Screase3D/Hexapod-MK3/docs/hexapod_schaltplan_v4.png

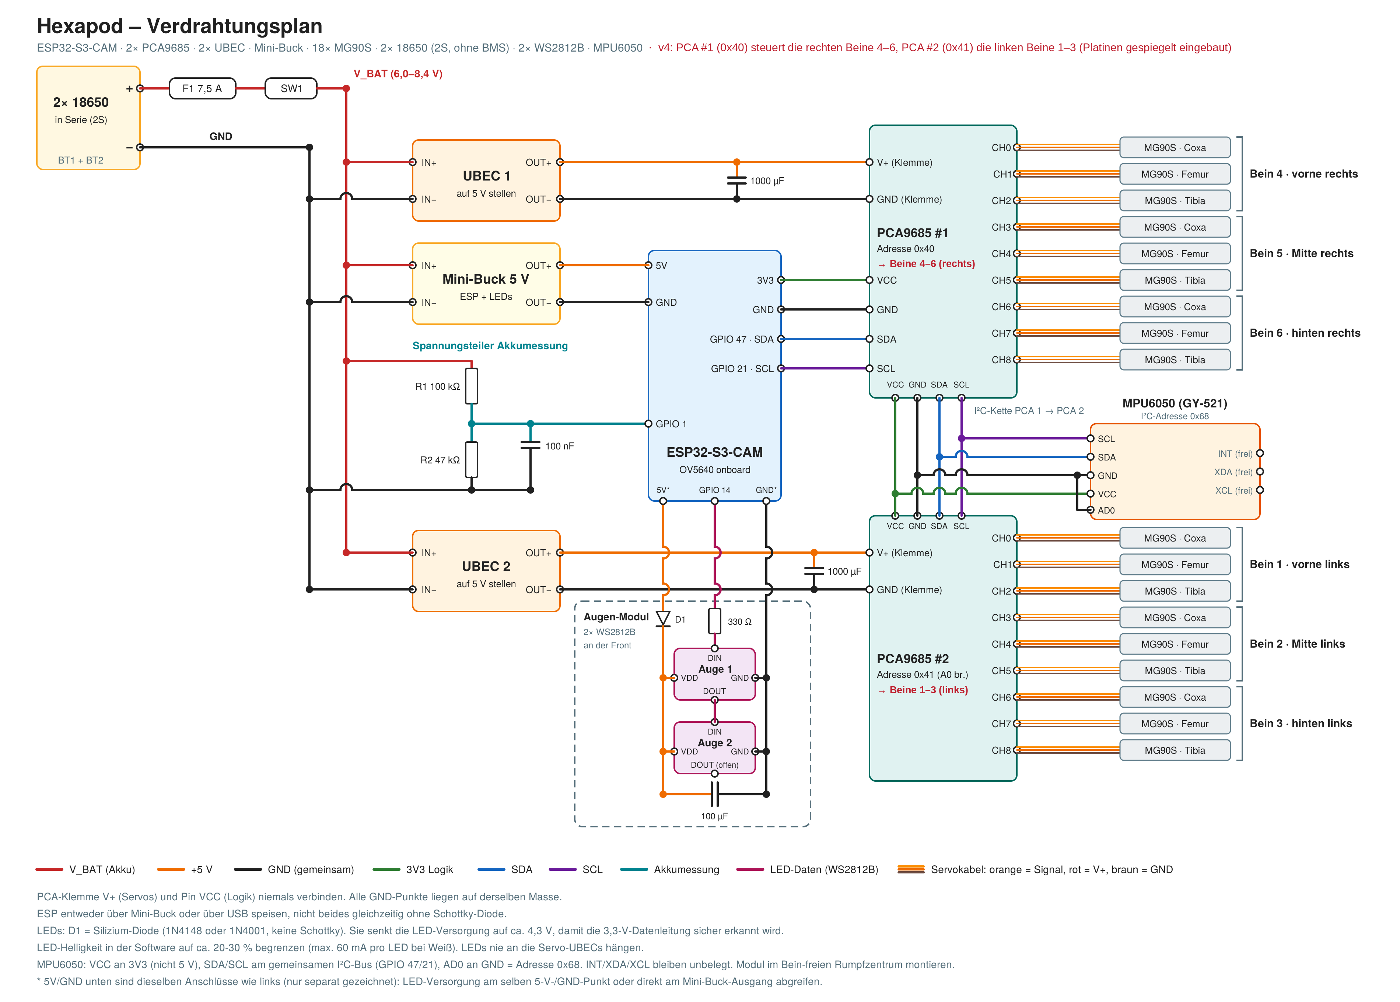
docs/hexapod_schaltplan_v4.png
