Screase3D/Hexapod-MK3/docs/images/ui-phone.png

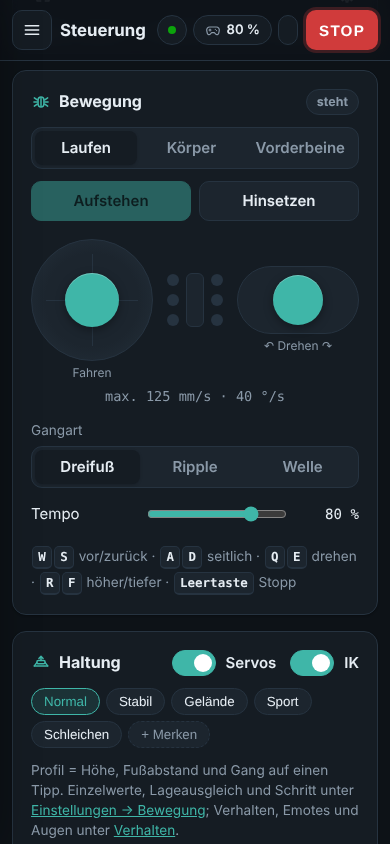
docs/images/ui-phone.png
