Screase3D/Hexapod-MK3/STL/Right Femur.stl

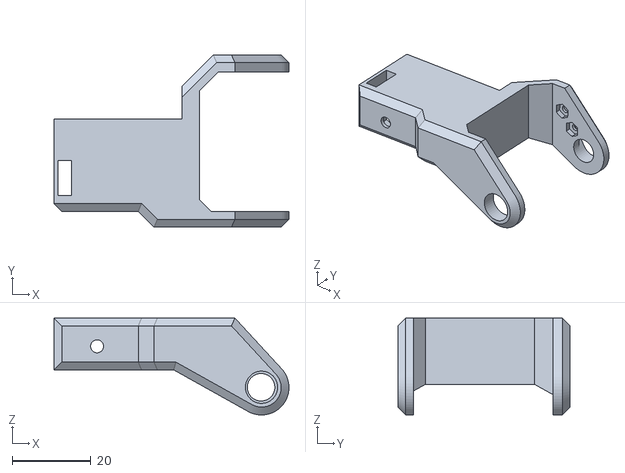
[picture p14: CAD file, 2026-10-17]
STL/Right Femur.stl
59.7 x 43.8 x 24.6
