Screase3D/Hexapod-MK3/STL/Left Tibia Bottom.stl

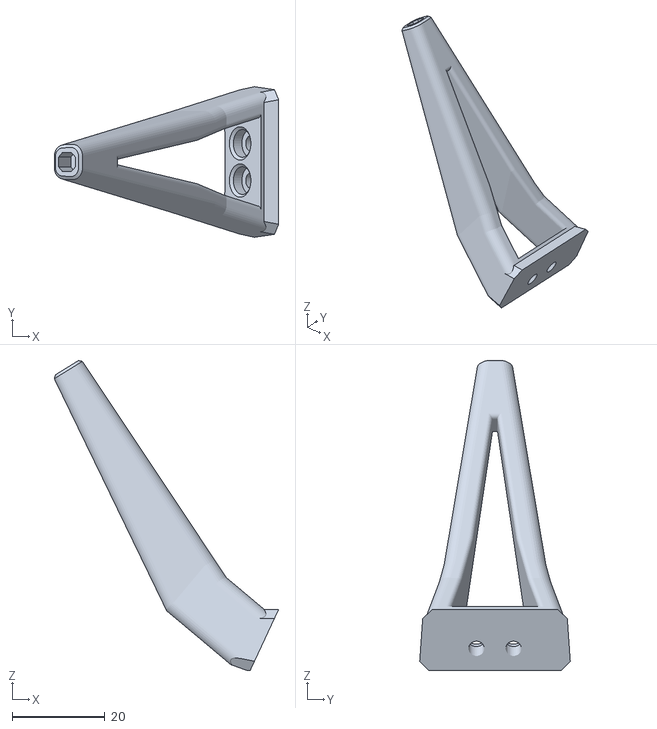
[picture p15: CAD file, 2026-10-17]
STL/Left Tibia Bottom.stl
48.4 x 32.5 x 66.8
