Screase3D/Hexapod-MK3/STL/DeckPlate.stl

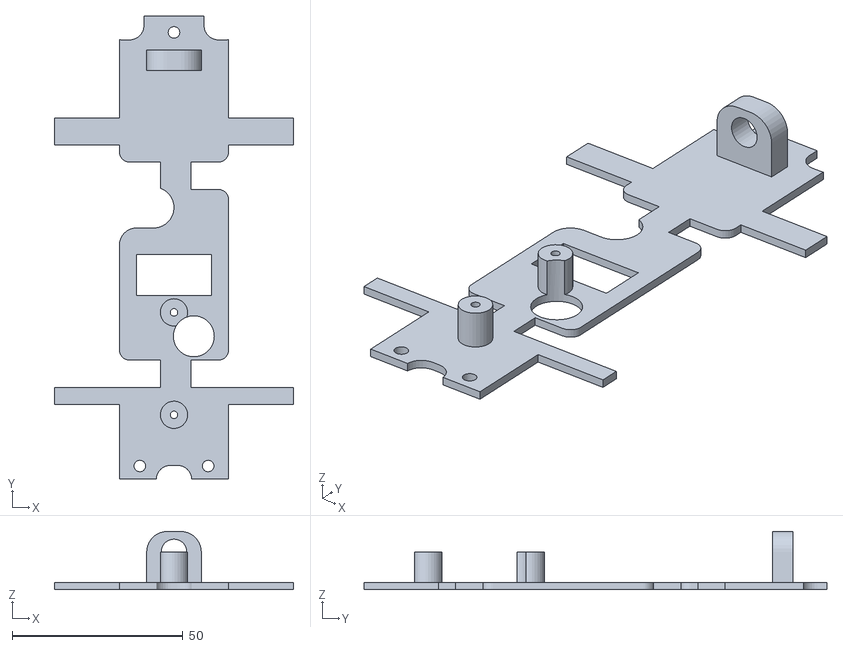
[picture p16: CAD file, 2026-10-17]
STL/DeckPlate.stl
70.0 x 135.6 x 17.0
