Screase3D/Hexapod-MK3/STL/Right Eye.stl

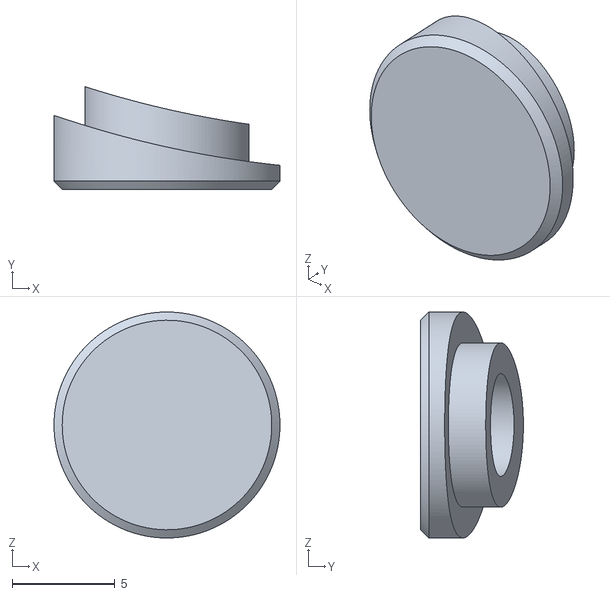
[picture p17: CAD file, 2026-10-17]
STL/Right Eye.stl
11.0 x 5.00 x 11.0
