Screase3D/Hexapod-MK3/STL/Left Coxa outer.stl

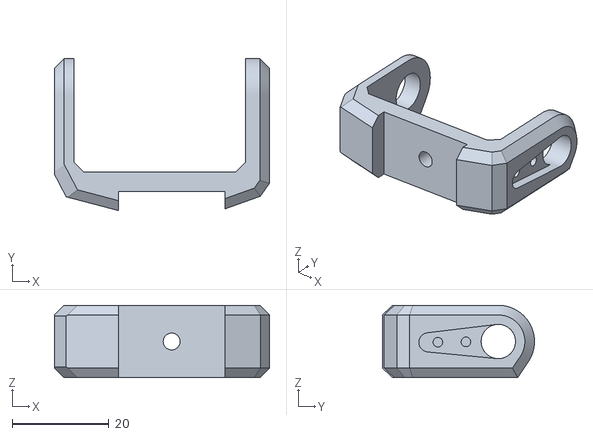
[picture p18: CAD file, 2026-10-17]
STL/Left Coxa outer.stl
44.5 x 31.5 x 15.0
