Screase3D/Hexapod-MK3/STL/TopPlate.stl

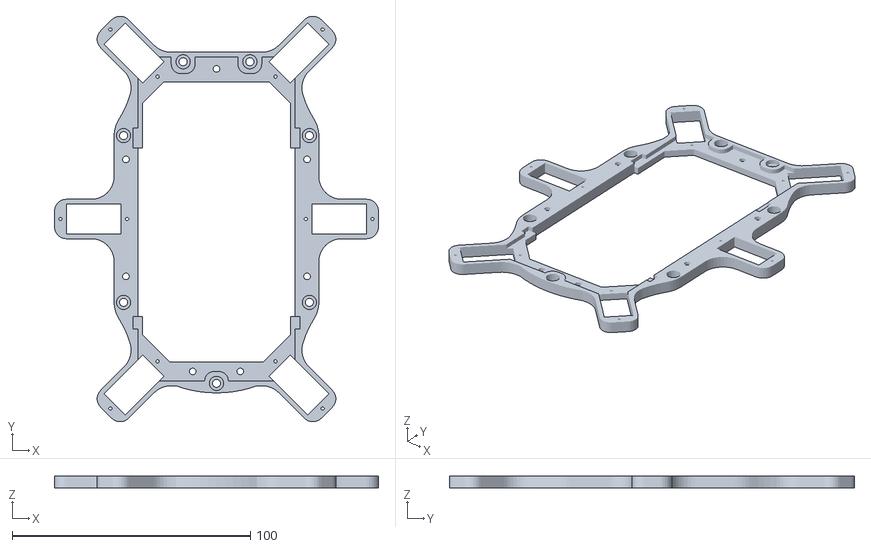
[picture p19: CAD file, 2026-10-17]
STL/TopPlate.stl
136.0 x 170.2 x 5.00
