Screase3D/Hexapod-MK3/STL/Heatsink_Dummy_9x9x4.6mm.stl

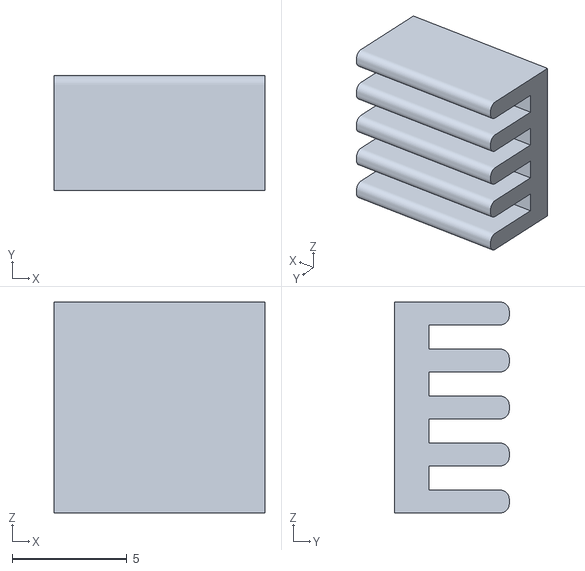
[picture p20: CAD file, 2026-10-17]
STL/Heatsink_Dummy_9x9x4.6mm.stl
9.20 x 5.00 x 9.20
