Screase3D/Hexapod-MK3/STL/Right Tibia Tip_TPU.stl

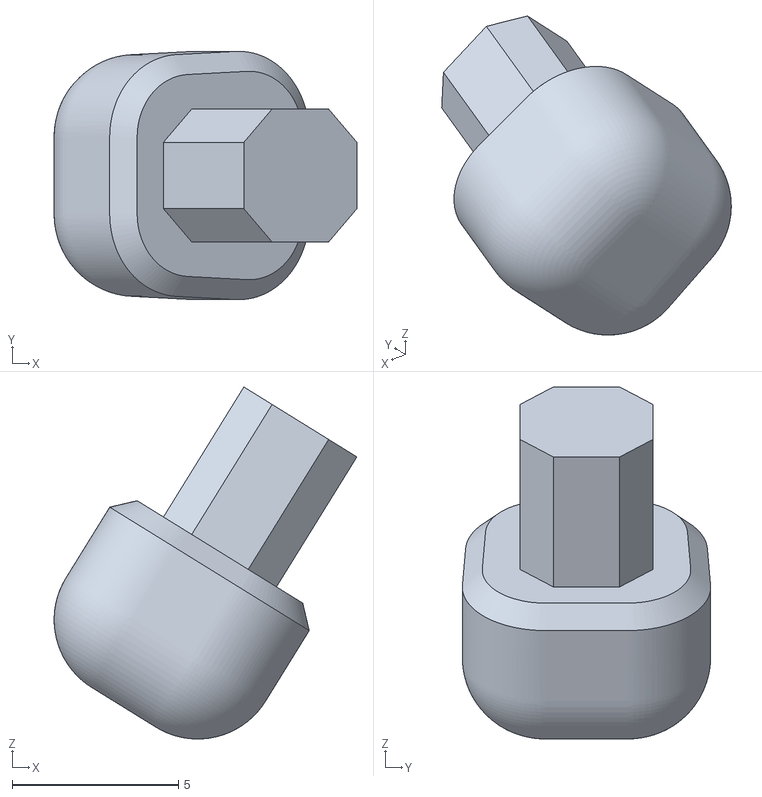
[picture p21: CAD file, 2026-10-17]
STL/Right Tibia Tip_TPU.stl
9.11 x 7.47 x 10.6
