Screase3D/Hexapod-MK3/STL/BatteryFlap.stl

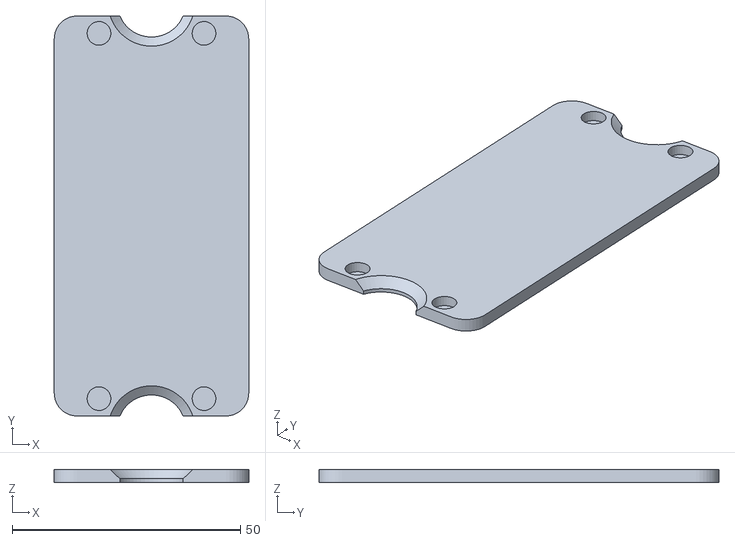
[picture p22: CAD file, 2026-10-17]
STL/BatteryFlap.stl
42.6 x 87.6 x 2.80
