Screase3D/Hexapod-MK3/STL/Left Tibia Top.stl

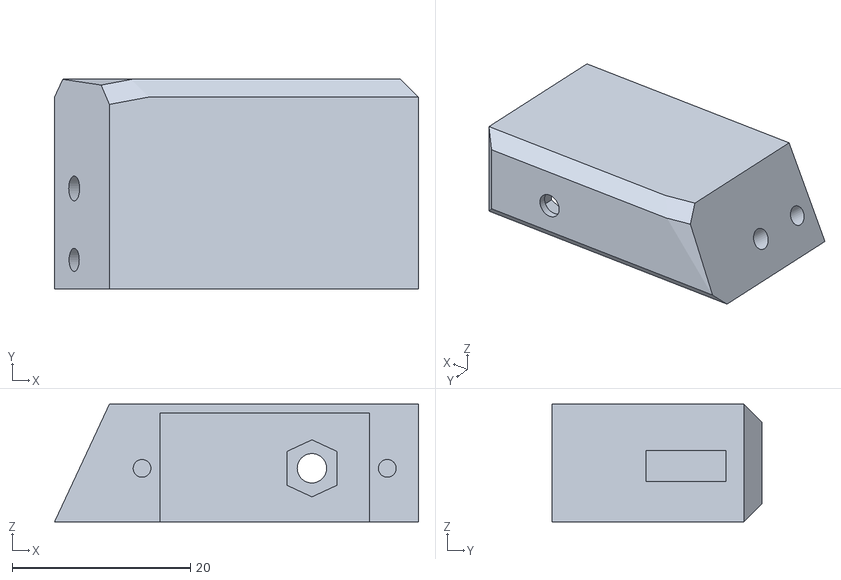
[picture p23: CAD file, 2026-10-17]
STL/Left Tibia Top.stl
40.8 x 23.5 x 13.2
