Screase3D/Hexapod-MK3/STL/Right Coxa inner.stl

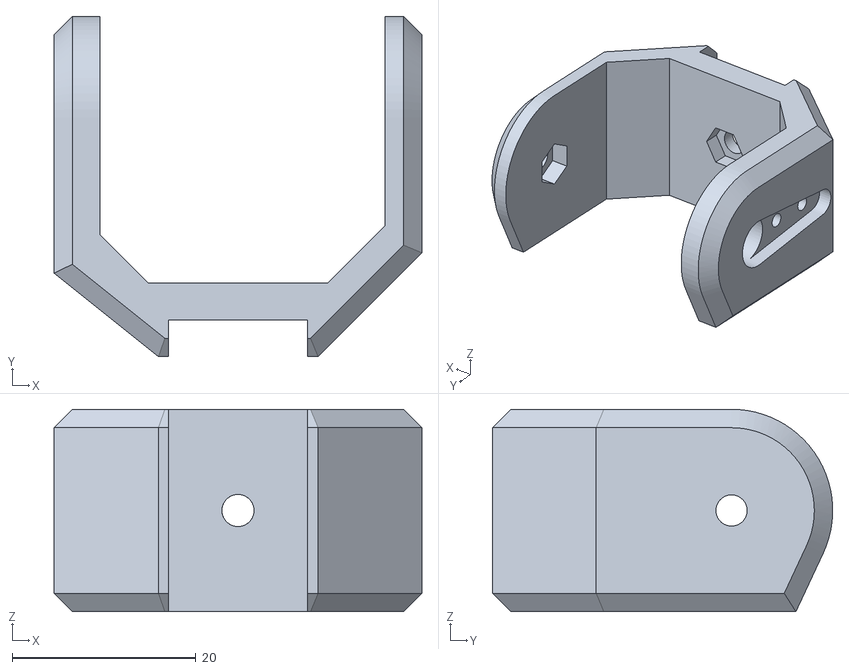
[picture p24: CAD file, 2026-10-17]
STL/Right Coxa inner.stl
40.0 x 37.0 x 22.0
