Screase3D/Hexapod-MK3/STL/Shell_openview.stl

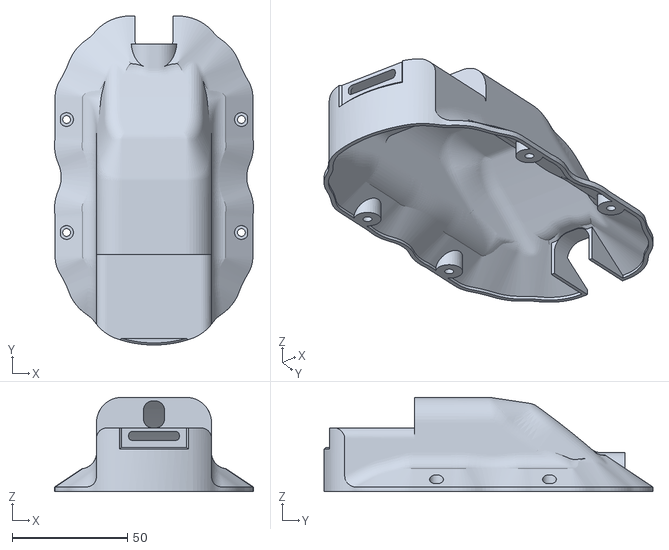
[picture p25: CAD file, 2026-10-17]
STL/Shell_openview.stl
86.5 x 143.0 x 41.0
