Screase3D/Hexapod-MK3/STL/BasePlate.stl

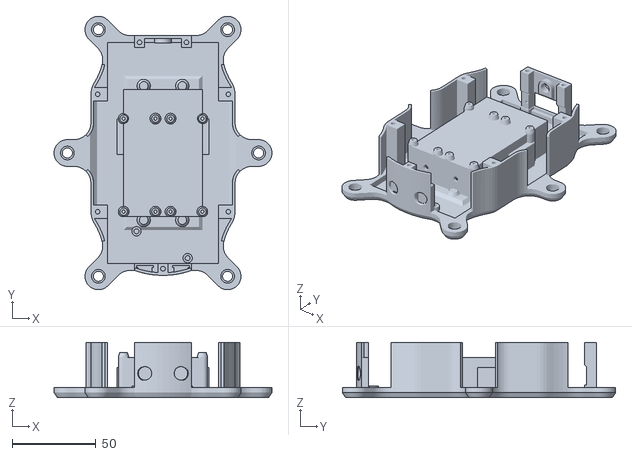
[picture p26: CAD file, 2026-10-17]
STL/BasePlate.stl
130.0 x 163.0 x 33.0
