Screase3D/Hexapod-MK3/STL/ESP_Cam Holder.stl

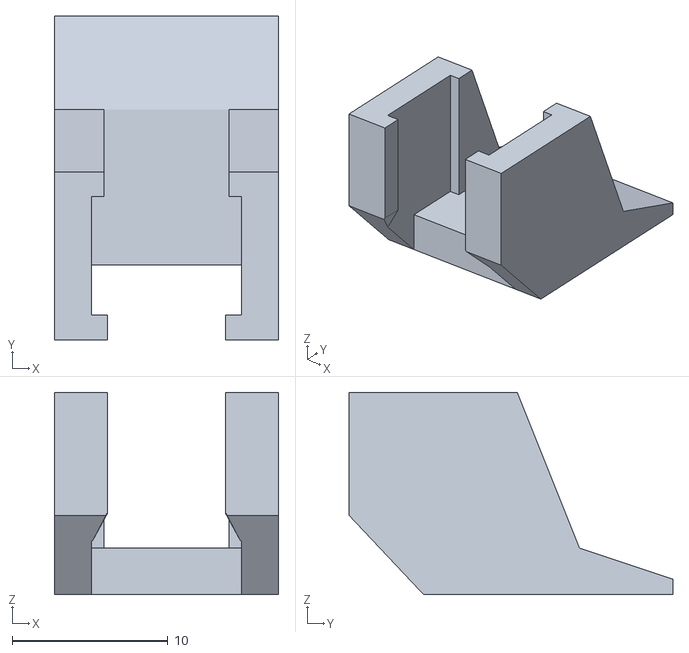
[picture p27: CAD file, 2026-10-17]
STL/ESP_Cam Holder.stl
14.4 x 20.8 x 13.0
