Screase3D/Hexapod-MK3/(list of files, cad)

Other CAD files:
STL/Right Tibia Bottom.stl
STL/Left Eye.stl
STL/Left Femur.stl
STL/Left Tibia Tip_TPU.stl
STL/Right Tibia Top.stl
STL/Right Coxa outer.stl
STL/Left Coxa inner.stl
