Screase3D/Hexapod-MK3/docs/montagelehre.pdf

# Hexapod MK3 – Montagelehre (1:1)

Montagestellung bei 1500 µs: Coxa 0° · Femur +55,4° · Tibia −33,8°. Mit 100 % / „Tatsächliche Größe“ drucken.

Kontrollmaß 50 mm – nachmessen, sonst stimmt der Maßstab nicht

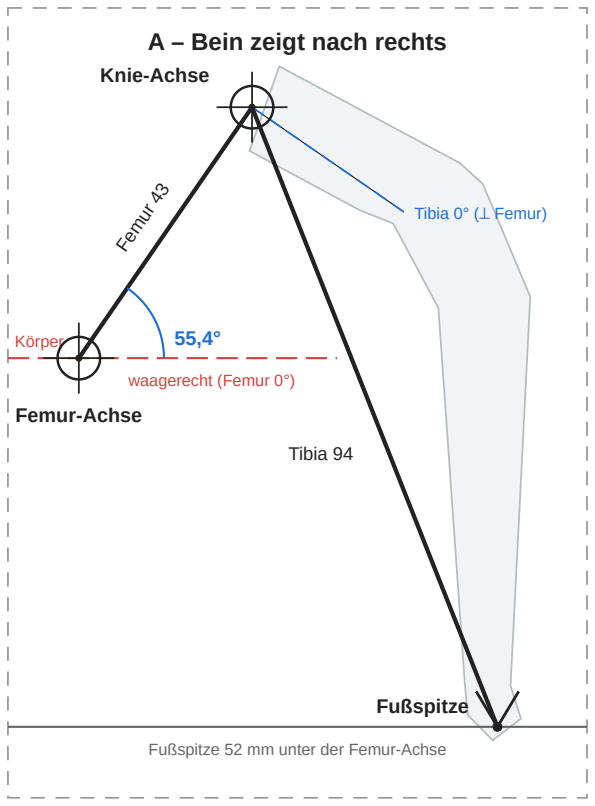
[picture p28: figure]
A – Bein zeigt nach rechts; waagerecht (Femur 0°); Körper; Fußspitze 52 mm unter der Femur-Achse; Femur 43; Tibia 94; Tibia 0° (⟂ Femur); Femur-Achse; Knie-Achse; Fußspitze

### C – Coxa-Winkel (Draufsicht)

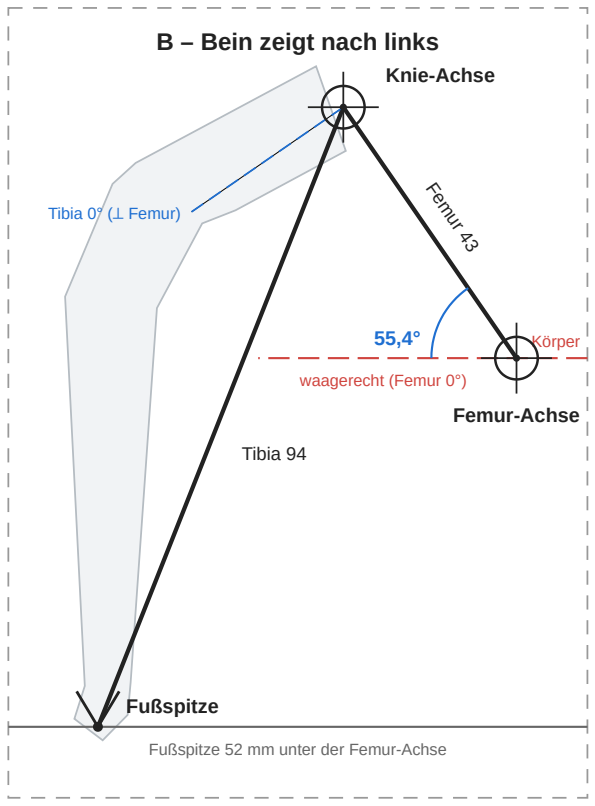
[picture p29: figure]
B – Bein zeigt nach links; waagerecht (Femur 0°); Körper; Fußspitze 52 mm unter der Femur-Achse; Femur 43; Tibia 94; Tibia 0° (⟂ Femur); Femur-Achse; Knie-Achse; Fußspitze
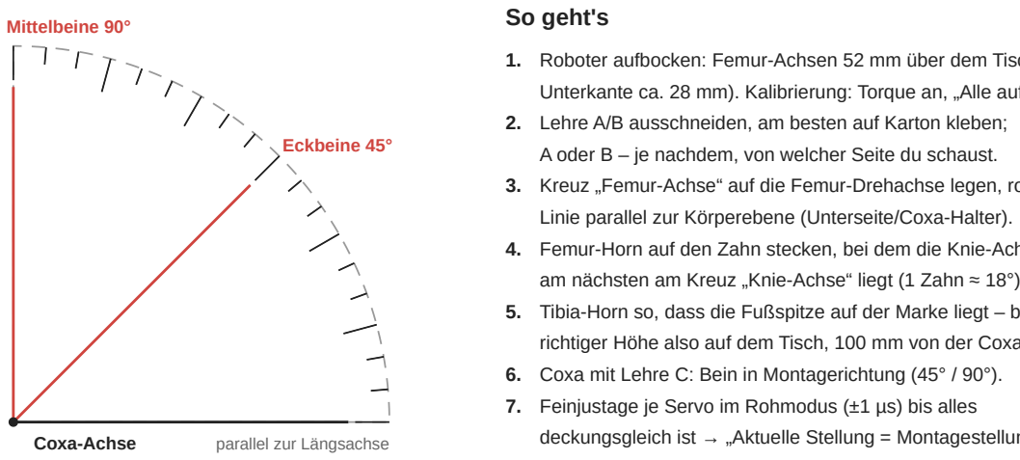
[picture p30: figure]
Coxa-Achse; parallel zur Längsachse; Eckbeine 45°; Mittelbeine 90°; So geht's; Linie parallel zur Körperebene (Unterseite/Coxa-Halter).

### 1. Roboter aufbocken: Femur-Achsen 52 mm über dem Tisch (Chassis-

Unterkante ca. 28 mm). Kalibrierung: Torque an, „Alle auf 1500 µs“.
2. Lehre A/B ausschneiden, am besten auf Karton kleben;
A oder B – je nachdem, von welcher Seite du schaust.

### 3. Kreuz „Femur-Achse“ auf die Femur-Drehachse legen, rote

### 4. Femur-Horn auf den Zahn stecken, bei dem die Knie-Achse

am nächsten am Kreuz „Knie-Achse“ liegt (1 Zahn ≈ 18°).

### 5. Tibia-Horn so, dass die Fußspitze auf der Marke liegt – bei

richtiger Höhe also auf dem Tisch, 100 mm von der Coxa-Achse.
6. Coxa mit Lehre C: Bein in Montagerichtung (45° / 90°).

### 7. Feinjustage je Servo im Rohmodus (±1 µs) bis alles

deckungsgleich ist → „Aktuelle Stellung = Montagestellung“.
Je Bein zuerst Femur, dann Tibia. Details: docs/kalibrierung.md

Linien = Achslinien (Drehpunkt zu Drehpunkt), nicht Bauteilkanten. Erzeugt mit docs/montagelehre.py.
