Screase3D/Hexapod-MK3/firmware/src/motion/motion.cpp

#include "motion.h"

#include <Preferences.h>
#include <atomic>
#include <freertos/FreeRTOS.h>

#include "config.h"
#include "kinematics/alive.h"
#include "kinematics/arms.h"
#include "kinematics/gait.h"
#include "kinematics/gestures.h"
#include "kinematics/kinematics.h"
#include "kinematics/leveling.h"
#include "kinematics/life.h"
#include "kinematics/posture.h"
#include "robot_geometry.h"
#include "sensors/imu.h"
#include "servo/servo_controller.h"
#include "ui/status_leds.h"

namespace motion {
namespace {

constexpr float RAD2DEG = 57.2957795f;
// Einstellungen erst speichern, wenn sich eine Weile nichts mehr geändert hat
// (Schieber erzeugen viele Änderungen, der Flash soll nicht unnötig altern)
constexpr uint32_t SAVE_DELAY_MS = 2000;
constexpr float LEVEL_TILT_MAX = 25.0f;  // Nutzer-Neigung + Lageausgleich zusammen
// Lageausgleich: im Stand schnell (Zeitkonstante 0,25 s), beim Laufen ruhiger – die Schritte
// schaukeln den Körper, darauf soll er nicht jedes Mal reagieren
constexpr float LEVEL_GAIN_STAND = 4.0f, LEVEL_GAIN_WALK = 1.5f;
// Übergang in den IK-Betrieb: Servos höchstens so schnell (Rest zwischen der bisherigen
// Stellung und der IK-Haltung), danach wieder die eingestellte Geschwindigkeit
constexpr float ENTER_SLEW_DEG_PER_S = 90.0f;
// Körper-Joystick: voller Ausschlag verschiebt bzw. neigt den Körper so weit
constexpr float BODY_SHIFT_MM = 30.0f;
constexpr float BODY_TILT_DEG = 12.0f;
constexpr float BODY_YAW_DEG = 15.0f;
constexpr uint32_t LIMITS_REFRESH_MS = 1000;  // Gelenkgrenzen aus der Kalibrierung neu lesen

struct PoseState {
  kin::BodyPose pose;
  float stance;
};

portMUX_TYPE g_mux = portMUX_INITIALIZER_UNLOCKED;
// --- geschützt durch g_mux (Web-Handler <-> Regel-Task) ---
Mode g_mode = Mode::Manual;
PoseState g_target;
bool g_enter_pose = false;      // beim Wechsel in den Pose-Modus Haltung übernehmen
bool g_leave_pose = false;      // Rampen-Untergrenze im Regel-Task zurücksetzen
bool g_req_stand = false;
bool g_req_sit = false;
posture::State g_posture = posture::State::Sitting;  // für die Telemetrie
float g_walk_cmd[3] = {0, 0, 0};
uint32_t g_walk_ms = 0;         // Zeitpunkt des letzten Fahrbefehls
gait::Params g_gait_params;
uint8_t g_unreachable = 0;      // Bitmaske Beine 0..5
uint32_t g_clamped = 0;         // Bitmaske Gelenke 0..17 (an Kalibriergrenze)
bool g_leveling = false;        // Lageausgleich eingeschaltet
bool g_level_fault = false;     // ... wegen falscher Sensorrichtung abgeschaltet
bool g_level_active = false;
float g_level_corr[2] = {0, 0};  // Roll, Nick
uint32_t g_dirty_ms = 0;        // letzte Änderung an gespeicherten Einstellungen (0 = keine)
struct GaitStatus {
  bool walking;
  uint8_t swing;
  float vx, vy, wz_deg, max_speed, max_side, max_turn_deg, nominal, cadence;
  gait::Type type;
  bool switching;  // Gangwechsel im Lauf läuft noch
  float climb_height;  // Fußhub beim Klettern (mm)
} g_status = {};
float g_body_cmd[5] = {0, 0, 0, 0, 0};  // Körper-Joystick: x, y, roll, pitch, yaw (normiert)
uint32_t g_body_ms = 0;
float g_arm_cmd[5] = {0, 0, 0, 0, 0};   // Vorderfüße: lx, lz, rx, rz, reach (normiert)
uint32_t g_arm_ms = 0;
uint8_t g_req_arms = 0;                 // 1 = heben, 2 = absetzen
bool g_req_wave = false;
gestures::Type g_req_gesture = gestures::Type::None;
bool g_req_gesture_stop = false;
arms::State g_arms_state = arms::State::Down;   // für Telemetrie und Befehlsprüfung
gestures::Type g_gesture = gestures::Type::None;
bool g_offset_limited = false;          // Körper-Joystick/Vorderbeine an der Reichweitengrenze
bool g_body_active = false;
bool g_alive = false;                   // "Lebendig" eingeschaltet
alive::Action g_alive_act = alive::Action::None;
life::Config g_life;                    // "Lebendig wirken"
life::Mood g_mood = life::Mood::Awake;  // für die Telemetrie
bool g_flailing = false;

// --- nur im Regel-Task ---
PoseState g_current;
gait::Gait g_gait;
posture::Sequencer g_seq{posture::Config{SIT_HEIGHT, SIT_STANCE, SIT_RISE_S}};
bool g_settling = false;  // Übergang in die IK-Haltung läuft noch (normale Rampe)
leveling::Controller g_level;
arms::Controller g_arms;
gestures::Player g_gest;
alive::Animator g_anim{LEG_MOUNTS};
life::Moods g_moods;
life::Breath g_breath;
life::LiftDetector g_lift;
life::Flail g_flail;
life::WalkFx g_walkfx;
alive::Action g_mood_play = alive::Action::None;  // wartet, bis "Lebendig" frei ist
uint32_t g_look_at = 0;                            // nach dem Anhalten umschauen (millis, 0 = nein)
float g_gaze = 0.0f;
bool g_life_eyes = false;                          // Augen-Vorgaben gesetzt
bool g_pending_sit = false;   // Hinsetzen, sobald die Vorderbeine unten sind
float g_lo[NUM_SERVOS], g_hi[NUM_SERVOS];
uint32_t g_limits_ms = 0;
kin::BodyPose g_ik_pose = {0, 0, POSE_LIMITS.height_default, 0, 0, 0};  // Körperlage der letzten IK
kin::BodyPose g_live_pose = g_ik_pose;  // dieselbe, unter g_mux (Live-Ansicht)
float g_pose_vel[7] = {0, 0, 0, 0, 0, 0, 0};
std::atomic<uint32_t> g_update_seq{0};  // abgeschlossene Regelschritte (update)  // Nachführen der Haltung: x, y, z, Rollen, Nicken, Gieren, Fußabstand

// Vorderbeine: Fußpunkt erreichbar (mit Abstand zu den Gelenkgrenzen)?
constexpr float ARM_MARGIN_DEG = 3.0f;
constexpr int FRONT_LEGS[2] = {0, 3};
bool armReachable(void*, int k, const kin::Vec3& foot) {
  const int leg = FRONT_LEGS[k];
  return kin::footReachable(LEG_GEOMETRY, LEG_MOUNTS[leg], g_ik_pose, foot, &g_lo[leg * 3], &g_hi[leg * 3],
                            ARM_MARGIN_DEG, KNEE_MIN_DEG);
}

PoseState defaults() {
  PoseState s;
  s.pose = {0.0f, 0.0f, POSE_LIMITS.height_default, 0.0f, 0.0f, 0.0f};
  s.stance = POSE_LIMITS.stance_default;
  return s;
}

PoseState sitState() {
  PoseState s;
  s.pose = {0.0f, 0.0f, SIT_HEIGHT, 0.0f, 0.0f, 0.0f};
  s.stance = SIT_STANCE;
  return s;
}

gait::Params defaultGait() {
  gait::Params p;
  p.swing_s = GAIT_LIMITS.swing_default;
  p.step_height = GAIT_LIMITS.height_default;
  p.max_stride = gaitStrideMax(p.step_height);
  return p;
}

// NaN (sollte nie vorkommen) wird zur Mitte des Bereichs statt durchgereicht
float clampf(float v, float lo, float hi) { return v < lo ? lo : (v > hi ? hi : (v == v ? v : 0.5f * (lo + hi))); }

float approach(float cur, float target, float max_step) {
  float d = target - cur;
  if (d > max_step) return cur + max_step;
  if (d < -max_step) return cur - max_step;
  return target;
}

// Folgt dem Ziel mit begrenzter Geschwindigkeit und Beschleunigung: weich anfahren,
// rechtzeitig abbremsen, ohne Überschwingen (vel = Zustand je Achse)
float glide(float cur, float target, float& vel, float vmax, float amax, float dt) {
  if (dt <= 0.0f) return cur;
  const float d = target - cur;
  // Bremsgeschwindigkeit im Regeltakt: kommt mit amax genau am Ziel zum Stehen
  const float ad = amax * dt;
  const float v_stop = ad * (sqrtf(0.25f + 2.0f * fabsf(d) / (ad * dt)) - 0.5f);
  const float v_want = copysignf(fminf(vmax, fminf(v_stop, fabsf(d) / dt)), d);
  vel = approach(vel, v_want, ad);
  const float next = cur + vel * dt;
  if ((target - next) * d <= 0.0f) {  // angekommen
    vel = 0.0f;
    return target;
  }
  return next;
}

void neutralFeet(float stance, kin::Vec3 out[NUM_LEGS]) {
  for (int leg = 0; leg < NUM_LEGS; ++leg) out[leg] = kin::stanceFoot(LEG_MOUNTS[leg], stance);
}

// Gelenkwinkel aller Beine für die Körperlage und Fußpunkte (Lauf-System);
// unerreichbare Beine behalten ihre bisherigen Werte (Bitmaske zurück)
uint8_t solveIk(const kin::BodyPose& pose, const kin::Vec3 feet[NUM_LEGS], float angles[NUM_SERVOS]) {
  uint8_t unreachable = 0;
  for (int leg = 0; leg < NUM_LEGS; ++leg) {
    const kin::LegMount& mount = LEG_MOUNTS[leg];
    kin::Vec3 foot_leg = kin::bodyToLeg(mount, kin::worldToBody(pose, feet[leg]));
    kin::JointAngles a;
    if (kin::legIk(LEG_GEOMETRY, mount, foot_leg, a)) {
      angles[leg * 3 + 0] = a.coxa;
      angles[leg * 3 + 1] = a.femur;
      angles[leg * 3 + 2] = a.tibia;
    } else {
      unreachable |= 1 << leg;
    }
  }
  return unreachable;
}

float g_angles[NUM_SERVOS] = {};

// ---- Haltungsprüfung: Füße auf den Neutralpunkten erreichbar und in den Gelenkgrenzen?
void readLimits(float lo[NUM_SERVOS], float hi[NUM_SERVOS]) {
  for (int i = 0; i < NUM_SERVOS; ++i) {
    ServoCal c = servos.getCal(i);
    lo[i] = c.min_deg;
    hi[i] = c.max_deg;
  }
}

kin::PoseCheck checkState(const PoseState& s, float mid_dx, const float* lo, const float* hi) {
  kin::Vec3 feet[NUM_LEGS];
  neutralFeet(s.stance, feet);
  feet[1].x += mid_dx;  // Mittelbeine (Vorderbeine-Modus)
  feet[4].x += mid_dx;
  return kin::checkPose(LEG_GEOMETRY, LEG_MOUNTS, NUM_LEGS, s.pose, feet, lo, hi);
}

PoseState lerpState(const PoseState& a, const PoseState& b, float t) {
  PoseState r;
  r.pose.x = a.pose.x + (b.pose.x - a.pose.x) * t;
  r.pose.y = a.pose.y + (b.pose.y - a.pose.y) * t;
  r.pose.z = a.pose.z + (b.pose.z - a.pose.z) * t;
  r.pose.roll_deg = a.pose.roll_deg + (b.pose.roll_deg - a.pose.roll_deg) * t;
  r.pose.pitch_deg = a.pose.pitch_deg + (b.pose.pitch_deg - a.pose.pitch_deg) * t;
  r.pose.yaw_deg = a.pose.yaw_deg + (b.pose.yaw_deg - a.pose.yaw_deg) * t;
  r.stance = a.stance + (b.stance - a.stance) * t;
  return r;
}

// "Lebendig"-Versatz mit Anteil k zu Körperlage und Füßen addieren
void addAlive(kin::BodyPose& p, kin::Vec3 feet[NUM_LEGS], const alive::Output& al, float k) {
  p.x += al.body.x * k;
  p.y += al.body.y * k;
  p.z += al.body.z * k;
  p.roll_deg += al.body.roll * k;
  p.pitch_deg += al.body.pitch * k;
  p.yaw_deg += al.body.yaw * k;
  for (int leg = 0; leg < NUM_LEGS; ++leg) {
    feet[leg].x += al.foot[leg].x * k;
    feet[leg].y += al.foot[leg].y * k;
    feet[leg].z += al.foot[leg].z * k;
  }
}

// ... und zwar so viel davon, wie erreichbar ist (Haltung nahe an den Grenzen)
void applyAlive(kin::BodyPose& pose, kin::Vec3 feet[NUM_LEGS], const alive::Output& al) {
  auto ok = [&](float k) {
    kin::BodyPose p = pose;
    kin::Vec3 f[NUM_LEGS];
    for (int leg = 0; leg < NUM_LEGS; ++leg) f[leg] = feet[leg];
    addAlive(p, f, al, k);
    return kin::checkPose(LEG_GEOMETRY, LEG_MOUNTS, NUM_LEGS, p, f, g_lo, g_hi).ok();
  };
  float k = 1.0f;
  if (!ok(1.0f)) {
    float k_bad = 1.0f;
    k = 0.0f;
    for (int i = 0; i < 8; ++i) {
      float mid = 0.5f * (k + k_bad);
      if (ok(mid)) k = mid;
      else k_bad = mid;
    }
  }
  addAlive(pose, feet, al, k);
}

// Größter Anteil t (0..1) des Wegs von a (zulässig) nach b, der zulässig bleibt
float feasibleFraction(const PoseState& a, const PoseState& b, float mid_dx, const float* lo, const float* hi) {
  if (checkState(b, mid_dx, lo, hi).ok()) return 1.0f;
  float t_ok = 0.0f, t_bad = 1.0f;
  for (int i = 0; i < 10; ++i) {
    float mid = 0.5f * (t_ok + t_bad);
    if (checkState(lerpState(a, b, mid), mid_dx, lo, hi).ok()) t_ok = mid;
    else t_bad = mid;
  }
  return t_ok;
}

// "Bein 2" bzw. "Beine 1, 4"
String legsText(uint8_t mask) {
  String s;
  for (int leg = 0; leg < NUM_LEGS; ++leg) {
    if (!(mask & (1 << leg))) continue;
    if (!s.isEmpty()) s += ", ";
    s += String(leg + 1);
  }
  return (__builtin_popcount(mask) > 1 ? "Beine " : "Bein ") + s;
}

struct PoseField {
  const char* key;
  const char* label;
  const char* unit;
};
constexpr PoseField POSE_FIELDS[] = {
    {"z", "Höhe", "mm"},         {"stance", "Fußabstand", "mm"}, {"x", "Vor/zurück", "mm"},
    {"y", "Links/rechts", "mm"}, {"roll", "Rollen", "°"},        {"pitch", "Nicken", "°"},
    {"yaw", "Gieren", "°"},
};

float fieldValue(const PoseState& s, int i) {
  switch (i) {
    case 0:  return s.pose.z;
    case 1:  return s.stance;
    case 2:  return s.pose.x;
    case 3:  return s.pose.y;
    case 4:  return s.pose.roll_deg;
    case 5:  return s.pose.pitch_deg;
    default: return s.pose.yaw_deg;
  }
}

void setFieldValue(PoseState& s, int i, float v) {
  switch (i) {
    case 0:  s.pose.z = v; break;
    case 1:  s.stance = v; break;
    case 2:  s.pose.x = v; break;
    case 3:  s.pose.y = v; break;
    case 4:  s.pose.roll_deg = v; break;
    case 5:  s.pose.pitch_deg = v; break;
    default: s.pose.yaw_deg = v; break;
  }
}

void fieldLimits(int i, float& lo, float& hi) {
  const PoseLimits& L = POSE_LIMITS;
  switch (i) {
    case 0:  lo = L.height_min, hi = L.height_max; break;
    case 1:  lo = L.stance_min, hi = L.stance_max; break;
    case 2:
    case 3:  lo = -L.shift_max, hi = L.shift_max; break;
    case 4:
    case 5:  lo = -L.tilt_max, hi = L.tilt_max; break;
    default: lo = -L.yaw_max, hi = L.yaw_max; break;
  }
}

// Zulässiger Bereich jeder Haltungsgröße bei den übrigen Zielwerten – für die Regler der
// Oberfläche. Einige hundert Haltungsprüfungen (wenige ms) -> nur bei geändertem Ziel und
// alle 2 s (Kalibrierung geändert). Nur aus dem Telemetrie-Aufbau (Hauptschleife).
struct RangeCtx {
  PoseState s;
  int field;
  const float* lo;
  const float* hi;
};
bool fieldOk(void* ctx, float v) {
  const RangeCtx* c = static_cast<const RangeCtx*>(ctx);
  PoseState s = c->s;
  setFieldValue(s, c->field, v);
  return checkState(s, 0.0f, c->lo, c->hi).ok();
}
constexpr uint32_t RANGE_REFRESH_MS = 2000;

// Was eine Haltung verhindert (für die Anzeige am Regler): Bein, Gelenk (0 Coxa, 1 Femur,
// 2 Tibia, 3 = Fuß nicht erreichbar) und die Kalibriergrenze, die am weitesten überschritten wäre
struct LimitWhy {
  int8_t leg = -1;  // < 0: keine Angabe
  int8_t joint = 0;
  float limit = 0.0f;
};
LimitWhy limitWhy(const PoseState& s, const float* lo, const float* hi) {
  kin::Vec3 feet[NUM_LEGS];
  neutralFeet(s.stance, feet);
  LimitWhy w;
  float worst = 0.0f;
  for (int leg = 0; leg < NUM_LEGS; ++leg) {
    kin::JointAngles a;
    if (!kin::legIk(LEG_GEOMETRY, LEG_MOUNTS[leg], kin::bodyToLeg(LEG_MOUNTS[leg], kin::worldToBody(s.pose, feet[leg])),
                    a)) {
      if (w.joint != 3) w = {static_cast<int8_t>(leg), 3, 0.0f};
      worst = 1e9f;
      continue;
    }
    const float v[3] = {a.coxa, a.femur, a.tibia};
    for (int j = 0; j < 3; ++j) {
      const float under = lo[leg * 3 + j] - v[j], over = v[j] - hi[leg * 3 + j];
      if (under > worst) worst = under, w = {static_cast<int8_t>(leg), static_cast<int8_t>(j), lo[leg * 3 + j]};
      if (over > worst) worst = over, w = {static_cast<int8_t>(leg), static_cast<int8_t>(j), hi[leg * 3 + j]};
    }
  }
  return w;
}

void poseRanges(const PoseState& t, float out[7][2], LimitWhy why_out[7][2]) {
  static PoseState last;
  static bool have = false;
  static uint32_t at = 0;
  static float cache[7][2];
  static LimitWhy why[7][2];
  const uint32_t now = millis();
  bool same = have && now - at < RANGE_REFRESH_MS;
  for (int i = 0; same && i < 7; ++i) same = fieldValue(last, i) == fieldValue(t, i);
  if (!same) {
    float lo[NUM_SERVOS], hi[NUM_SERVOS];
    readLimits(lo, hi);
    RangeCtx c{t, 0, lo, hi};
    // Ziel selbst nicht zulässig (z. B. nach neuer Kalibrierung): keine Einschränkung
    // anzeigen, sonst ließe sich kein Regler mehr bewegen; das Begrenzen übernimmt applyPoseJson
    const bool target_ok = checkState(t, 0.0f, lo, hi).ok();
    for (int i = 0; i < 7; ++i) {
      c.field = i;
      float a, b;
      fieldLimits(i, a, b);
      if (target_ok) kin::feasibleInterval(fieldOk, &c, fieldValue(t, i), a, b, 16, 5, cache[i][0], cache[i][1]);
      else cache[i][0] = a, cache[i][1] = b;
      // Grund an jedem Rand, der enger als die Oberflächen-Grenze ist (knapp dahinter nachsehen)
      for (int e = 0; e < 2; ++e) {
        why[i][e] = LimitWhy();
        const float edge = cache[i][e], outer = e ? b : a;
        if (!target_ok || fabsf(edge - outer) < 0.05f) continue;
        PoseState s = t;
        setFieldValue(s, i, edge + (e ? 0.5f : -0.5f));
        why[i][e] = limitWhy(s, lo, hi);
      }
    }
    last = t;
    have = true;
    at = now;
  }
  for (int i = 0; i < 7; ++i) {
    out[i][0] = cache[i][0], out[i][1] = cache[i][1];
    why_out[i][0] = why[i][0], why_out[i][1] = why[i][1];
  }
}

// Klettern: Fußhub so hoch, wie Knie und Femur (Grenze aus der Kalibrierung) es zulassen,
// auch wenn ein Ecken-Bein beim Vorwärtslaufen bis CLIMB_INWARD mm zum Körper hin steht
// (höchstens CLIMB_MAX_MM, mindestens der normale Fußhub)
constexpr float CLIMB_MAX_MM = 45.0f;
constexpr float CLIMB_INWARD = 20.0f;

// Reichweite für die Gangart: Coxa-Achsen im Lauf-System (Körper verschoben bzw.
// gedreht) und erlaubter Fußabstand, damit das Knie beim Anheben nicht zu weit
// einknickt. minFootRadius rechnet etwas länger -> nur bei Änderungen.
// Setzt gp.climb_height (Klettern).
void updateReach(const PoseState& cur, gait::Params& gp) {
  static float last_z = -1.0f, last_stance = -1.0f, last_lift = -1.0f, last_fmax = 0.0f;
  static bool last_climb = false;
  static float r_min = 0.0f, r_max = 0.0f, climb_h = CLIMB_MAX_MM;
  const bool climb = gp.type == gait::Type::Climb || g_gait.activeType() == gait::Type::Climb;
  float fmax = 180.0f;  // Femur höchstens (mit Abstand zur Grenze)
  for (int leg = 0; leg < NUM_LEGS; ++leg) fmax = fminf(fmax, g_hi[leg * 3 + 1] - ARM_MARGIN_DEG);
  if (fabsf(cur.pose.z - last_z) > 0.25f || fabsf(cur.stance - last_stance) > 0.25f ||
      gp.step_height != last_lift || climb != last_climb || fmax != last_fmax) {
    last_z = cur.pose.z;
    last_stance = cur.stance;
    last_lift = gp.step_height;
    last_climb = climb;
    last_fmax = fmax;
    climb_h = gait::climbHeight(LEG_GEOMETRY, cur.stance, cur.pose.z, CLIMB_INWARD, KNEE_MIN_DEG, fmax,
                                gp.step_height, CLIMB_MAX_MM);
    r_min = climb ? gait::minFootRadius(LEG_GEOMETRY, cur.stance, cur.pose.z, climb_h, KNEE_MIN_DEG, true, fmax)
                  : gait::minFootRadius(LEG_GEOMETRY, cur.stance, cur.pose.z, gp.step_height, KNEE_MIN_DEG);
    r_max = gait::maxFootRadius(LEG_GEOMETRY, cur.pose.z);
  }
  gp.climb_height = climb_h;
  kin::Vec3 coxa[NUM_LEGS];
  for (int leg = 0; leg < NUM_LEGS; ++leg) coxa[leg] = kin::coxaWorld(cur.pose, LEG_MOUNTS[leg]);
  g_gait.setReach(coxa, r_min, r_max);
  g_gait.setSwingGuard(LEG_GEOMETRY, cur.pose.z, KNEE_MIN_DEG);
}

// ---- Gespeicherte Einstellungen (NVS): Haltung, Gang, Lageausgleich, Stellgeschwindigkeit
constexpr const char* NVS_NAMESPACE = "hexapod";
constexpr const char* NVS_KEY = "motion";
constexpr uint32_t BLOB_MAGIC = 0x48584D31;  // "HXM1"
constexpr uint16_t BLOB_VERSION = 1;
constexpr uint8_t FLAG_LEVELING = 1, FLAG_ALIVE = 2, FLAG_POSE = 4;

struct SettingsBlob {
  uint32_t magic;
  uint16_t version;
  uint8_t gait_type;
  uint8_t flags;  // Bit 0: Lageausgleich, Bit 1: Lebendig, Bit 2: IK-Betrieb (frühere Fassung: nur Lageausgleich 0/1)
  float x, y, z, roll, pitch, yaw, stance;
  float swing_s, step_height;
  float slew;
};

// "Lebendig wirken": eigener Eintrag (fehlt er, ist alles an)
constexpr const char* NVS_KEY_LIFE = "life";
constexpr uint32_t LIFE_MAGIC = 0x48584C31;  // "HXL1"
constexpr uint8_t LIFE_BREATHE = 1, LIFE_BORED = 2, LIFE_LIFT = 4, LIFE_WALK = 8, LIFE_GAZE = 16;
struct LifeBlob {
  uint32_t magic;
  uint16_t version;  // 1: ohne lift_sens
  uint8_t flags;
  uint8_t sleep_min;
  uint8_t lift_sens;
  uint8_t reserved[3];
};
constexpr size_t LIFE_BLOB_V1 = 8;

void markDirty() {
  uint32_t now = millis();
  g_dirty_ms = now ? now : 1;
}

void loadSettings() {
  Preferences prefs;
  if (!prefs.begin(NVS_NAMESPACE, true)) return;
  SettingsBlob b;
  size_t len = prefs.getBytes(NVS_KEY, &b, sizeof(b));
  prefs.end();
  if (len != sizeof(b) || b.magic != BLOB_MAGIC || b.version != BLOB_VERSION) return;
  const float vals[] = {b.x, b.y, b.z, b.roll, b.pitch, b.yaw, b.stance, b.swing_s, b.step_height, b.slew};
  for (float v : vals) {
    if (!isfinite(v)) return;
  }
  const PoseLimits& L = POSE_LIMITS;
  const GaitLimits& G = GAIT_LIMITS;
  g_target.pose.x = clampf(b.x, -L.shift_max, L.shift_max);
  g_target.pose.y = clampf(b.y, -L.shift_max, L.shift_max);
  g_target.pose.z = clampf(b.z, L.height_min, L.height_max);
  g_target.pose.roll_deg = clampf(b.roll, -L.tilt_max, L.tilt_max);
  g_target.pose.pitch_deg = clampf(b.pitch, -L.tilt_max, L.tilt_max);
  g_target.pose.yaw_deg = clampf(b.yaw, -L.yaw_max, L.yaw_max);
  g_target.stance = clampf(b.stance, L.stance_min, L.stance_max);
  if (b.gait_type < gait::NUM_TYPES) g_gait_params.type = static_cast<gait::Type>(b.gait_type);
  g_gait_params.swing_s = clampf(b.swing_s, G.swing_min, G.swing_max);
  g_gait_params.step_height = clampf(b.step_height, G.height_min, G.height_max);
  g_gait_params.max_stride = gaitStrideMax(g_gait_params.step_height);
  g_leveling = (b.flags & FLAG_LEVELING) != 0;
  g_alive = (b.flags & FLAG_ALIVE) != 0;
  if (b.flags & FLAG_POSE) {
    // IK-Betrieb wie vor dem Neustart; ohne Torque beginnt er in der Sitzhaltung
    g_mode = Mode::Pose;
    g_enter_pose = true;
  }
  if (b.slew > 0.0f) servos.setSlewDegPerS(b.slew);
}

void loadLife() {
  Preferences prefs;
  if (!prefs.begin(NVS_NAMESPACE, true)) return;
  LifeBlob b;
  b.lift_sens = 2;
  size_t len = prefs.getBytes(NVS_KEY_LIFE, &b, sizeof(b));
  prefs.end();
  const bool v1 = len == LIFE_BLOB_V1 && b.version == 1, v2 = len == sizeof(b) && b.version == 2;
  if (b.magic != LIFE_MAGIC || !(v1 || v2)) return;
  if (v1) b.lift_sens = 2;
  g_life.breathe = b.flags & LIFE_BREATHE;
  g_life.bored = b.flags & LIFE_BORED;
  g_life.lift = b.flags & LIFE_LIFT;
  g_life.walk_fx = b.flags & LIFE_WALK;
  g_life.gaze = b.flags & LIFE_GAZE;
  g_life.sleep_s = 60.0f * constrain(b.sleep_min, 1, 60);
  g_life.lift_sens = constrain(b.lift_sens, 1, 3);
}

void saveLife() {
  portENTER_CRITICAL(&g_mux);
  const life::Config c = g_life;
  portEXIT_CRITICAL(&g_mux);
  LifeBlob b = {};
  b.magic = LIFE_MAGIC;
  b.version = 2;
  b.lift_sens = c.lift_sens;
  b.flags = (c.breathe ? LIFE_BREATHE : 0) | (c.bored ? LIFE_BORED : 0) | (c.lift ? LIFE_LIFT : 0) |
            (c.walk_fx ? LIFE_WALK : 0) | (c.gaze ? LIFE_GAZE : 0);
  b.sleep_min = static_cast<uint8_t>(lroundf(c.sleep_s / 60.0f));
  Preferences prefs;
  if (!prefs.begin(NVS_NAMESPACE, false)) return;
  LifeBlob old;
  // nur schreiben, wenn sich etwas geändert hat (Haltung wird viel öfter gespeichert)
  if (prefs.getBytes(NVS_KEY_LIFE, &old, sizeof(old)) != sizeof(old) || memcmp(&old, &b, sizeof(b)) != 0) {
    prefs.putBytes(NVS_KEY_LIFE, &b, sizeof(b));
  }
  prefs.end();
}

void saveSettings() {
  portENTER_CRITICAL(&g_mux);
  PoseState t = g_target;
  gait::Params gp = g_gait_params;
  bool lvl = g_leveling;
  bool alv = g_alive;
  const bool pose = g_mode == Mode::Pose;
  portEXIT_CRITICAL(&g_mux);
  SettingsBlob b = {};
  b.magic = BLOB_MAGIC;
  b.version = BLOB_VERSION;
  b.gait_type = static_cast<uint8_t>(gp.type);
  b.flags = (lvl ? FLAG_LEVELING : 0) | (alv ? FLAG_ALIVE : 0) | (pose ? FLAG_POSE : 0);
  b.x = t.pose.x;
  b.y = t.pose.y;
  b.z = t.pose.z;
  b.roll = t.pose.roll_deg;
  b.pitch = t.pose.pitch_deg;
  b.yaw = t.pose.yaw_deg;
  b.stance = t.stance;
  b.swing_s = gp.swing_s;
  b.step_height = gp.step_height;
  b.slew = servos.slewDegPerS();
  Preferences prefs;
  if (!prefs.begin(NVS_NAMESPACE, false)) return;
  prefs.putBytes(NVS_KEY, &b, sizeof(b));
  prefs.end();
  saveLife();
}

}  // namespace

void begin() {
  g_target = defaults();
  g_current = sitState();
  g_gait_params = defaultGait();
  loadSettings();  // zuletzt eingestellte Haltung, Gang, Lageausgleich, Lebendig, Stellgeschwindigkeit
  loadLife();
  g_anim.seed(esp_random());
  g_gait.setParams(g_gait_params);
  kin::Vec3 n[NUM_LEGS];
  neutralFeet(g_current.stance, n);
  g_gait.reset(n);
  g_seq.reset(posture::State::Sitting);
  // Startsollwert der Servos: Sitzhaltung. Liegt der Roboter beim Einschalten
  // von Torque auf dem Bauch, drücken die Beine ihn so nicht ruckartig hoch.
  kin::Vec3 feet[NUM_LEGS];
  for (int leg = 0; leg < NUM_LEGS; ++leg) feet[leg] = g_gait.foot(leg);
  if (solveIk(g_current.pose, feet, g_angles) == 0) {
    servos.setAnglesDeg(g_angles);
    servos.setSafePose(g_angles);  // Torque ein: immer erst hierher, dann langsam weiter
  }
  readLimits(g_lo, g_hi);
}

void setMode(Mode m) {
  portENTER_CRITICAL(&g_mux);
  if (m == Mode::Pose && g_mode != Mode::Pose) {
    g_enter_pose = true;
  }
  if (m != g_mode) markDirty();  // IK-Zustand wird gespeichert
  const bool leave = m != Mode::Pose && g_mode == Mode::Pose;
  if (leave) {
    g_leave_pose = true;
    g_walk_cmd[0] = g_walk_cmd[1] = g_walk_cmd[2] = 0.0f;
  }
  g_mode = m;
  const uint32_t seq = g_update_seq.load();
  portEXIT_CRITICAL(&g_mux);
  if (leave) {
    // Ein gerade laufender Regelschritt im IK-Betrieb schreibt am Ende noch seine Winkel:
    // abwarten, sonst überschreibt er einen gleich folgenden Handbefehl ("alle auf 1500 µs")
    const uint32_t t0 = millis();
    while (g_update_seq.load() == seq && millis() - t0 < 100) delay(1);
  }
}

Mode mode() {
  portENTER_CRITICAL(&g_mux);
  Mode m = g_mode;
  portEXIT_CRITICAL(&g_mux);
  return m;
}

bool applyPoseJson(JsonVariantConst o, String& note) {
  // JSON außerhalb des kritischen Abschnitts auswerten, nur das Kopieren sperren
  portENTER_CRITICAL(&g_mux);
  PoseState next = g_target;
  portEXIT_CRITICAL(&g_mux);
  const PoseState before = next;

  const PoseLimits& L = POSE_LIMITS;
  kin::BodyPose& p = next.pose;
  if (o["x"].is<float>()) p.x = clampf(o["x"], -L.shift_max, L.shift_max);
  if (o["y"].is<float>()) p.y = clampf(o["y"], -L.shift_max, L.shift_max);
  if (o["z"].is<float>()) p.z = clampf(o["z"], L.height_min, L.height_max);
  if (o["roll"].is<float>()) p.roll_deg = clampf(o["roll"], -L.tilt_max, L.tilt_max);
  if (o["pitch"].is<float>()) p.pitch_deg = clampf(o["pitch"], -L.tilt_max, L.tilt_max);
  if (o["yaw"].is<float>()) p.yaw_deg = clampf(o["yaw"], -L.yaw_max, L.yaw_max);
  if (o["stance"].is<float>()) next.stance = clampf(o["stance"], L.stance_min, L.stance_max);

  // Haltung prüfen: nicht erreichbar oder außerhalb der Gelenkgrenzen -> auf den
  // nächsten zulässigen Wert zwischen bisheriger und gewünschter Haltung begrenzen
  float lo[NUM_SERVOS], hi[NUM_SERVOS];
  readLimits(lo, hi);
  bool limited = false;
  kin::PoseCheck want = checkState(next, 0.0f, lo, hi);
  if (!want.ok()) {
    PoseState base = before;
    if (!checkState(base, 0.0f, lo, hi).ok()) base = defaults();
    if (checkState(base, 0.0f, lo, hi).ok()) {
      PoseState wanted = next;
      next = lerpState(base, wanted, feasibleFraction(base, wanted, 0.0f, lo, hi));
      limited = true;
      String changed;
      for (int i = 0; i < 7; ++i) {
        if (!o[POSE_FIELDS[i].key].is<float>()) continue;
        float want_v = fieldValue(wanted, i), got = fieldValue(next, i);
        if (fabsf(want_v - got) < 0.5f) continue;
        if (!changed.isEmpty()) changed += ", ";
        changed += String(POSE_FIELDS[i].label) + " auf " + String(got, 0) + " " + POSE_FIELDS[i].unit +
                   " (gewünscht " + String(want_v, 0) + ")";
      }
      note = "Haltung begrenzt: " + (changed.isEmpty() ? String("Kombination") : changed) + " – ";
      if (want.unreachable) {
        note += legsText(want.unreachable);
        note += __builtin_popcount(want.unreachable) > 1 ? " erreichen den Boden nicht" : " erreicht den Boden nicht";
      }
      if (want.unreachable && want.limited) note += ", ";
      if (want.limited) note += legsText(want.limited) + " an der Gelenkgrenze (Kalibrierung)";
    } else {
      note = "Haltung nicht erreichbar: " + legsText(want.unreachable | want.limited);
    }
  }

  portENTER_CRITICAL(&g_mux);
  g_target = next;
  markDirty();
  portEXIT_CRITICAL(&g_mux);
  return limited;
}

void resetPose() {
  portENTER_CRITICAL(&g_mux);
  g_target = defaults();
  markDirty();
  portEXIT_CRITICAL(&g_mux);
}

bool applyLifeJson(JsonVariantConst in, String& err) {
  portENTER_CRITICAL(&g_mux);
  life::Config c = g_life;
  portEXIT_CRITICAL(&g_mux);
  if (in["breathe"].is<bool>()) c.breathe = in["breathe"];
  if (in["bored"].is<bool>()) c.bored = in["bored"];
  if (in["lift"].is<bool>()) c.lift = in["lift"];
  if (in["walk_fx"].is<bool>()) c.walk_fx = in["walk_fx"];
  if (in["gaze"].is<bool>()) c.gaze = in["gaze"];
  if (in["lift_sens"].is<int>()) {
    const int v = in["lift_sens"];
    if (v < 1 || v > 3) {
      err = "lift_sens muss 1–3 sein";
      return false;
    }
    c.lift_sens = static_cast<uint8_t>(v);
  }
  if (in["sleep_min"].is<float>()) {
    const float m = in["sleep_min"];
    if (!(m >= 1.0f && m <= 60.0f)) {
      err = "sleep_min muss 1–60 sein";
      return false;
    }
    c.sleep_s = 60.0f * roundf(m);
  }
  portENTER_CRITICAL(&g_mux);
  g_life = c;
  markDirty();
  portEXIT_CRITICAL(&g_mux);
  return true;
}

void setAlive(bool on) {
  portENTER_CRITICAL(&g_mux);
  g_alive = on;
  markDirty();
  portEXIT_CRITICAL(&g_mux);
}

void setLeveling(bool on) {
  portENTER_CRITICAL(&g_mux);
  g_leveling = on;
  if (on) g_level_fault = false;  // neuer Versuch (Regler wird im Regel-Task zurückgesetzt)
  markDirty();
  portEXIT_CRITICAL(&g_mux);
}

void notifySettingsChanged() {
  portENTER_CRITICAL(&g_mux);
  markDirty();
  portEXIT_CRITICAL(&g_mux);
}

void loop() {
  portENTER_CRITICAL(&g_mux);
  uint32_t dirty = g_dirty_ms;
  portEXIT_CRITICAL(&g_mux);
  if (dirty == 0 || millis() - dirty < SAVE_DELAY_MS) return;
  portENTER_CRITICAL(&g_mux);
  if (g_dirty_ms == dirty) g_dirty_ms = 0;  // in der Zwischenzeit nichts Neues
  portEXIT_CRITICAL(&g_mux);
  saveSettings();
}

void stand() {
  portENTER_CRITICAL(&g_mux);
  if (g_mode != Mode::Pose) {
    g_mode = Mode::Pose;
    g_enter_pose = true;  // beginnt in der Haltung, in der er gerade ist (sitzt meist)
    markDirty();
  }
  g_req_stand = true;
  g_req_sit = false;
  portEXIT_CRITICAL(&g_mux);
}

void sit() {
  portENTER_CRITICAL(&g_mux);
  if (g_mode != Mode::Pose) {
    g_mode = Mode::Pose;
    g_enter_pose = true;
    markDirty();
  }
  g_req_sit = true;
  g_req_stand = false;
  g_walk_cmd[0] = g_walk_cmd[1] = g_walk_cmd[2] = 0.0f;
  portEXIT_CRITICAL(&g_mux);
}

void walk(float vx, float vy, float turn) {
  portENTER_CRITICAL(&g_mux);
  // Nur im IK-Betrieb: aus dem Handbetrieb (z. B. nach dem Start, Servos in Sitzstellung)
  // würde der Roboter sonst ohne Aufstehen-Ablauf direkt in die Standhaltung springen
  if (g_mode != Mode::Pose) {
    portEXIT_CRITICAL(&g_mux);
    return;
  }
  g_walk_cmd[0] = clampf(vx, -1.0f, 1.0f);
  g_walk_cmd[1] = clampf(vy, -1.0f, 1.0f);
  g_walk_cmd[2] = clampf(turn, -1.0f, 1.0f);
  g_walk_ms = millis();
  portEXIT_CRITICAL(&g_mux);
}

void stopWalking() {
  portENTER_CRITICAL(&g_mux);
  g_walk_cmd[0] = g_walk_cmd[1] = g_walk_cmd[2] = 0.0f;
  portEXIT_CRITICAL(&g_mux);
}

bool applyGaitJson(JsonVariantConst o, String& err) {
  portENTER_CRITICAL(&g_mux);
  gait::Params next = g_gait_params;
  portEXIT_CRITICAL(&g_mux);

  if (o["type"].is<const char*>()) {
    gait::Type t;
    if (!gait::typeFromName(o["type"].as<const char*>(), t)) {
      err = "unbekannte Gangart (tripod, ripple, wave, climb)";
      return false;
    }
    next.type = t;
  }
  const GaitLimits& L = GAIT_LIMITS;
  if (o["swing_s"].is<float>()) next.swing_s = clampf(o["swing_s"], L.swing_min, L.swing_max);
  if (o["step_height"].is<float>()) {
    next.step_height = clampf(o["step_height"], L.height_min, L.height_max);
  }
  next.max_stride = gaitStrideMax(next.step_height);

  portENTER_CRITICAL(&g_mux);
  g_gait_params = next;
  markDirty();
  portEXIT_CRITICAL(&g_mux);
  return true;
}

const char* cycleGait(int dir) {
  portENTER_CRITICAL(&g_mux);
  const int t = (static_cast<int>(g_gait_params.type) + dir % gait::NUM_TYPES + gait::NUM_TYPES) % gait::NUM_TYPES;
  g_gait_params.type = static_cast<gait::Type>(t);
  markDirty();
  portEXIT_CRITICAL(&g_mux);
  return gait::typeName(static_cast<gait::Type>(t));
}

bool nudgeHeight(float dz, String& note) {
  portENTER_CRITICAL(&g_mux);
  const float z = g_target.pose.z;
  portEXIT_CRITICAL(&g_mux);
  JsonDocument d;
  d["z"] = z + dz;
  return applyPoseJson(d.as<JsonVariantConst>(), note);
}

// ---- Körper-Joystick, Vorderbeine, Gesten (Befehle aus dem Web-Task) ----

namespace {
// Zustandskopie für die Befehlsprüfung (der Regel-Task prüft erneut). Keine
// String- oder Mutex-Operationen im kritischen Abschnitt!
struct Snapshot {
  Mode mode;
  posture::State posture;
  bool walking;
  arms::State arms;
};

Snapshot snapshot() {
  portENTER_CRITICAL(&g_mux);
  Snapshot s{g_mode, g_posture, g_status.walking, g_arms_state};
  portEXIT_CRITICAL(&g_mux);
  return s;
}

bool standingNow(const Snapshot& s, String& err) {
  if (s.mode != Mode::Pose || s.posture != posture::State::Standing) {
    err = "Erst aufstehen";
    return false;
  }
  return true;
}
}  // namespace

void body(float x, float y, float roll, float pitch, float yaw) {
  portENTER_CRITICAL(&g_mux);
  g_body_cmd[0] = clampf(x, -1.0f, 1.0f);
  g_body_cmd[1] = clampf(y, -1.0f, 1.0f);
  g_body_cmd[2] = clampf(roll, -1.0f, 1.0f);
  g_body_cmd[3] = clampf(pitch, -1.0f, 1.0f);
  g_body_cmd[4] = clampf(yaw, -1.0f, 1.0f);
  g_body_ms = millis();
  portEXIT_CRITICAL(&g_mux);
}

bool setArms(bool up, String& err) {
  if (up) {
    const Snapshot s = snapshot();
    if (!standingNow(s, err)) return false;
    if (s.walking) {
      err = "Erst anhalten";
      return false;
    }
    if (!servos.torqueRequested()) {
      err = "Erst Torque einschalten";
      return false;
    }
    // Die volle Gewichtsverlagerung muss in der eingestellten Haltung erreichbar sein
    portENTER_CRITICAL(&g_mux);
    PoseState shifted = g_target;
    portEXIT_CRITICAL(&g_mux);
    const arms::Config ac;
    shifted.pose.x -= ac.cog_shift;
    float lo[NUM_SERVOS], hi[NUM_SERVOS];
    readLimits(lo, hi);
    if (!checkState(shifted, ac.mid_forward, lo, hi).ok()) {
      err = "In dieser Haltung kann er das Gewicht nicht nach hinten verlagern – erst Haltung zurücksetzen";
      return false;
    }
  }
  portENTER_CRITICAL(&g_mux);
  g_req_arms = up ? 1 : 2;
  g_req_gesture_stop = true;
  portEXIT_CRITICAL(&g_mux);
  return true;
}

void armControl(float lx, float lz, float rx, float rz, float reach) {
  portENTER_CRITICAL(&g_mux);
  g_arm_cmd[0] = clampf(lx, -1.0f, 1.0f);
  g_arm_cmd[1] = clampf(lz, -1.0f, 1.0f);
  g_arm_cmd[2] = clampf(rx, -1.0f, 1.0f);
  g_arm_cmd[3] = clampf(rz, -1.0f, 1.0f);
  g_arm_cmd[4] = clampf(reach, -1.0f, 1.0f);
  g_arm_ms = millis();
  portEXIT_CRITICAL(&g_mux);
}

bool wave(String& err) {
  if (snapshot().arms != arms::State::Up) {
    err = "Erst die Vorderbeine heben";
    return false;
  }
  portENTER_CRITICAL(&g_mux);
  g_req_wave = true;
  portEXIT_CRITICAL(&g_mux);
  return true;
}

bool gesture(const char* name, String& err) {
  if (name && strcmp(name, "stop") == 0) {
    portENTER_CRITICAL(&g_mux);
    g_req_gesture_stop = true;
    portEXIT_CRITICAL(&g_mux);
    return true;
  }
  gestures::Type t;
  if (!gestures::typeFromName(name, t)) {
    err = "unbekannte Geste (circle, nod, shake, pushup, dance, stop)";
    return false;
  }
  const Snapshot s = snapshot();
  if (!standingNow(s, err)) return false;
  if (s.arms != arms::State::Down) {
    err = "Erst die Vorderbeine absetzen";
    return false;
  }
  if (s.walking) {
    err = "Erst anhalten";
    return false;
  }
  portENTER_CRITICAL(&g_mux);
  g_req_gesture = t;
  g_req_gesture_stop = false;
  portEXIT_CRITICAL(&g_mux);
  return true;
}

namespace {
void updateStep(float dt);
}

void update(float dt) {
  updateStep(dt);
  g_update_seq.fetch_add(1);
}

namespace {
void updateStep(float dt) {
  portENTER_CRITICAL(&g_mux);
  Mode m = g_mode;
  PoseState target = g_target;
  bool entering = g_enter_pose;
  bool leaving = g_leave_pose;
  bool req_stand = g_req_stand;
  bool req_sit = g_req_sit;
  bool leveling_on = g_leveling && !g_level_fault;
  bool alive_on = g_alive;
  const life::Config lc = g_life;
  g_enter_pose = g_leave_pose = g_req_stand = g_req_sit = false;
  gait::Params gp = g_gait_params;
  float cmd[3] = {g_walk_cmd[0], g_walk_cmd[1], g_walk_cmd[2]};
  uint32_t walk_ms = g_walk_ms;
  float body_cmd[5];
  for (int i = 0; i < 5; ++i) body_cmd[i] = g_body_cmd[i];
  uint32_t body_ms = g_body_ms;
  float arm_cmd[5];
  for (int i = 0; i < 5; ++i) arm_cmd[i] = g_arm_cmd[i];
  uint32_t arm_ms = g_arm_ms;
  uint8_t req_arms = g_req_arms;
  bool req_wave = g_req_wave;
  gestures::Type req_gesture = g_req_gesture;
  bool req_gesture_stop = g_req_gesture_stop;
  g_req_arms = 0;
  g_req_wave = g_req_gesture_stop = false;
  g_req_gesture = gestures::Type::None;
  portEXIT_CRITICAL(&g_mux);

  if (leaving) {
    servos.setSlewFloor(0.0f);
    servos.setSlewCap(0.0f);
    g_arms.reset();
    g_gest.reset();
    g_anim.reset();
    g_flail.reset();
    g_walkfx.reset();
    g_moods = life::Moods(millis() | 1u);
    g_mood_play = alive::Action::None;
  }
  if (m != Mode::Pose) {
    if (g_life_eyes) {  // Augen wieder nur nach Zustand
      statusLeds.setLife(StatusLeds::Life());
      g_life_eyes = false;
    }
    return;
  }

  const uint32_t now = millis();
  if (now - g_limits_ms > LIMITS_REFRESH_MS) {
    readLimits(g_lo, g_hi);
    g_limits_ms = now;
  }

  kin::Vec3 neutral[NUM_LEGS];
  const bool powered = servos.torqueRequested() && !servos.emergencyStopActive();
  // Ohne Kraft in den Servos liegt der Roboter -> Sitzhaltung (beim nächsten
  // Einschalten fahren die Beine dorthin, statt ihn hochzudrücken)
  bool collapse = !powered && g_seq.state() != posture::State::Sitting;
  if (entering || collapse) {
    // Von der tatsächlichen Haltung aus weitermachen (aus den Servowinkeln geschätzt) – nie
    // in die Standhaltung springen. Sitzt bzw. liegt er (z. B. nach dem Start), beginnt der
    // IK-Betrieb im Sitzen, Aufstehen per Befehl; steht er schon (z. B. Montagestellung),
    // geht es auf seiner jetzigen Höhe weiter und die Haltung gleitet zum Ziel.
    float h = SIT_HEIGHT, st = SIT_STANCE;
    float deg[NUM_SERVOS];
    servos.anglesDeg(deg);
    const bool est = kin::estimateStance(LEG_GEOMETRY, LEG_MOUNTS, NUM_LEGS, deg, h, st);
    const bool standing_now = !collapse && powered && est && h > SIT_HEIGHT + 6.0f &&
                              h >= 0.5f * (SIT_HEIGHT + target.pose.z);
    if (standing_now) {
      const PoseLimits& L = POSE_LIMITS;
      g_current = target;
      g_current.pose = {0.0f, 0.0f, clampf(h, L.height_min, L.height_max), 0.0f, 0.0f, 0.0f};
      g_current.stance = clampf(st, L.stance_min, L.stance_max);
    } else {
      g_current = sitState();
    }
    for (float& v : g_pose_vel) v = 0.0f;
    g_seq.reset(standing_now ? posture::State::Standing : posture::State::Sitting);
    neutralFeet(g_current.stance, neutral);
    g_gait.reset(neutral);
    g_arms.reset();
    g_gest.reset();
    g_anim.reset();
    g_flail.reset();
    g_walkfx.reset();
    g_pending_sit = false;
    servos.setSlewFloor(0.0f);
    servos.setSlewCap(ENTER_SLEW_DEG_PER_S);  // Rest zur IK-Haltung langsam fahren
    g_settling = true;
  }
  if (req_stand && powered) g_seq.requestStand();
  // Hinsetzen: Gesten beenden, Vorderbeine erst absetzen
  if (req_sit) {
    g_gest.stop();
    if (g_arms.active()) {
      g_arms.requestDown();
      g_pending_sit = true;
    } else {
      g_seq.requestSit();
    }
  }
  if (g_pending_sit && !g_arms.active()) {
    g_seq.requestSit();
    g_pending_sit = false;
  }
  // Übergang abgeschlossen -> schnellere Rampe, damit die Füße den (glatten)
  // Schrittbahnen ohne Verzögerung folgen
  if (g_settling && servos.atTarget(3.0f)) {
    g_settling = false;
    servos.setSlewCap(0.0f);
    servos.setSlewFloor(GAIT_SERVO_SLEW_DEG_PER_S);
  }
  const bool standing = !g_settling && powered && g_seq.state() == posture::State::Standing;

  // Vorderbeine: heben nur im Stillstand; während sie oben sind, wird nicht gelaufen
  if (req_arms == 1 && standing && g_gait.idle() && !g_pending_sit) {
    g_gest.reset();
    g_arms.requestUp();
  }
  if (req_arms == 2 || !standing) g_arms.requestDown();
  if (req_wave) g_arms.wave();
  const bool arm_fresh = now - arm_ms < WALK_TIMEOUT_MS;
  g_arms.setControl(arm_fresh ? arm_cmd[0] : 0.0f, arm_fresh ? arm_cmd[1] : 0.0f,
                    arm_fresh ? arm_cmd[2] : 0.0f, arm_fresh ? arm_cmd[3] : 0.0f, arm_fresh ? arm_cmd[4] : 0.0f);

  // Eingaben (für "gelangweilt"): frische Fahr-, Körper- und Vorderbein-Befehle, Gesten,
  // Aufstehen/Hinsetzen, geänderte Zielhaltung
  auto nonzero = [](const float* v, int n) {
    for (int i = 0; i < n; ++i) {
      if (fabsf(v[i]) > 0.02f) return true;
    }
    return false;
  };
  const bool move_in = (now - walk_ms < WALK_TIMEOUT_MS && nonzero(cmd, 3)) ||
                       (now - body_ms < WALK_TIMEOUT_MS && nonzero(body_cmd, 5)) ||
                       (now - arm_ms < WALK_TIMEOUT_MS && nonzero(arm_cmd, 5)) ||
                       req_gesture != gestures::Type::None || req_arms == 1 || req_wave || req_stand;
  static PoseState last_target = target;
  bool target_changed = false;
  for (int i = 0; i < 7; ++i) target_changed |= fieldValue(target, i) != fieldValue(last_target, i);
  last_target = target;
  const bool activity = move_in || req_sit || req_arms != 0 || req_gesture_stop || target_changed;

  // Sicherheit: ohne frische Befehle, Torque oder bei Not-Aus nicht laufen;
  // laufen nur im Stehen und mit abgesetzten Vorderbeinen
  const bool can_walk = standing && !g_arms.active() && now - walk_ms < WALK_TIMEOUT_MS;
  if (!can_walk) cmd[0] = cmd[1] = cmd[2] = 0.0f;
  const bool walk_cmd = fabsf(cmd[0]) > 1e-3f || fabsf(cmd[1]) > 1e-3f || fabsf(cmd[2]) > 1e-3f;

  // Gesten: nur im Stand mit abgesetzten Vorderbeinen; Laufen beendet sie
  if (req_gesture != gestures::Type::None && standing && !g_arms.active() && g_gait.idle() && !walk_cmd) {
    g_gest.start(req_gesture);
  }
  if (req_gesture_stop || walk_cmd || !standing || g_arms.active()) g_gest.stop();

  // Haltungswechsel (sitzen/aufstehen/hinsetzen) geben Höhe und Fußabstand vor;
  // solange der Übergang in die Haltung läuft, wartet der Ablauf
  posture::Output po = g_seq.update(g_settling ? 0.0f : dt, target.pose.z, target.stance,
                                    g_current.pose.z, g_gait.idle());
  PoseState goal = target;
  if (po.active) {
    goal.pose = {0.0f, 0.0f, po.height, 0.0f, 0.0f, 0.0f};  // Körper gerade ausrichten
    goal.stance = po.stance;
  }

  // Körper-Joystick (federt ohne neue Befehle zurück) und Gewichtsverlagerung der
  // Vorderbeine; was die Beine nicht erreichen, wird zurückgenommen
  arms::Frame af;
  neutralFeet(g_current.stance, neutral);
  for (int k = 0; k < 2; ++k) {
    af.coxa[k] = kin::coxaWorld(g_ik_pose, LEG_MOUNTS[FRONT_LEGS[k]]);
    af.ground[k] = neutral[FRONT_LEGS[k]];
  }
  af.reachable = armReachable;
  const arms::Output ao = g_arms.update(dt, g_gait.idle(), af);
  const bool body_fresh = standing && !po.active && now - body_ms < WALK_TIMEOUT_MS;
  bool offset_limited = false;
  if (!po.active) {
    // Gewichtsverlagerung der Vorderbeine immer voll (Standsicherheit!), wurde
    // beim Befehl auf Erreichbarkeit geprüft
    goal.pose.x += ao.body_dx;
    PoseState wanted = goal;
    if (body_fresh) {
      wanted.pose.x += body_cmd[0] * BODY_SHIFT_MM;
      wanted.pose.y += body_cmd[1] * BODY_SHIFT_MM;
      wanted.pose.roll_deg += body_cmd[2] * BODY_TILT_DEG;
      wanted.pose.pitch_deg += body_cmd[3] * BODY_TILT_DEG;
      wanted.pose.yaw_deg += body_cmd[4] * BODY_YAW_DEG;
    }
    if (body_fresh) {
      float t = feasibleFraction(goal, wanted, ao.mid_dx, g_lo, g_hi);
      offset_limited = t < 0.999f;
      goal = lerpState(goal, wanted, t);
    }
  }

  // Gesten: Versatz kommt nach der Geschwindigkeitsbegrenzung (schon weich)
  const gestures::Offset go = g_gest.update(dt);

  // "Lebendig": kleine Bewegungen, nur wenn er still steht und sonst nichts läuft
  const bool alive_allowed = standing && !po.active && g_gait.idle() && !walk_cmd && !g_arms.active() &&
                             g_gest.active() == gestures::Type::None && !body_fresh;

  // "Lebendig wirken": Stimmung – gelangweilt (gähnt, seufzt, schaut sich um), schläft
  // schließlich ein (setzt sich), Eingaben wecken ihn (steht auf, streckt sich)
  life::MoodIn mi;
  mi.dt = dt;
  mi.enabled = lc.bored && powered;
  mi.standing = standing;
  mi.still = alive_allowed && !g_flail.active();
  mi.activity = activity;
  mi.move = move_in;
  const life::MoodOut mo = g_moods.update(mi, lc.sleep_s);
  if (activity) {
    g_mood_play = alive::Action::None;
    g_look_at = 0;
  }
  if (mo.play != alive::Action::None) g_mood_play = mo.play;
  if (mo.sit && !g_arms.active()) g_seq.requestSit();
  if (mo.stand && powered) g_seq.requestStand();
  if (g_look_at && (int32_t)(now - g_look_at) >= 0) {  // nach dem Anhalten umschauen
    if (g_mood_play == alive::Action::None) g_mood_play = alive::Action::Look;
    g_look_at = 0;
  }
  if (g_mood_play != alive::Action::None && alive_allowed && !g_flail.active() &&
      g_anim.action() == alive::Action::None) {
    g_anim.play(g_mood_play);
    g_mood_play = alive::Action::None;
  }
  g_anim.setBreath(!lc.breathe);  // sonst atmet "life"
  const alive::Output al = g_anim.update(dt, alive_on, alive_allowed);

  // Hochgehoben? -> zappeln (Dreiergruppen abwechselnd: steht auch bei Fehlerkennung sicher)
  life::LiftIn li;
  li.dt = dt;
  li.armed = lc.lift && imu.ok() && alive_allowed && !g_flail.active();
  li.moving = g_anim.action() != alive::Action::None;  // eigene Bewegung: Drehung erst ab mehr
  imu.accelG(li.acc);
  imu.gyroDps(li.gyro);
  // gemessene minus gewollte Neigung (Körperlage der letzten IK, inkl. Lageausgleich)
  li.tilt_err[0] = imu.rollDeg() - g_ik_pose.roll_deg;
  li.tilt_err[1] = imu.pitchDeg() - g_ik_pose.pitch_deg;
  li.sens = lc.lift_sens;
  if (g_lift.update(li)) g_flail.start();
  if (!standing || po.active || walk_cmd || body_fresh || g_arms.active() || g_gest.active() != gestures::Type::None) {
    g_flail.stop();
  }
  alive::Output lo = g_flail.update(dt);

  // Atmen (im Stand) und Laufen mit Charakter (Trägheit, Blick voraus, Hüftschwung)
  lo.body.z += g_breath.update(dt, lc.breathe && standing && !po.active && g_gait.idle() && !walk_cmd &&
                                      !g_arms.active());
  if (lc.walk_fx && standing && !po.active && !g_arms.active()) {
    life::WalkIn wi;
    wi.dt = dt;
    wi.on = !g_gait.idle();
    wi.vx = g_gait.speedX();
    wi.vy = g_gait.speedY();
    wi.wz = g_gait.turnRate() * RAD2DEG;
    wi.max_speed = g_gait.maxSpeed();
    wi.max_turn = g_gait.maxTurn() * RAD2DEG;
    wi.phase = g_gait.phase();
    const gestures::Offset wf = g_walkfx.update(wi);
    lo.body.x += wf.x;
    lo.body.y += wf.y;
    lo.body.z += wf.z;
    lo.body.roll += wf.roll;
    lo.body.pitch += wf.pitch;
    lo.body.yaw += wf.yaw;
    if (g_walkfx.stopped() && random(100) < 45) g_look_at = (now + 900) | 1u;
  } else {
    g_walkfx.reset();
  }
  bool life_on = false;
  for (const kin::Vec3& f : lo.foot) life_on |= f.z != 0.0f || f.x != 0.0f;
  life_on |= lo.body.x != 0.0f || lo.body.y != 0.0f || lo.body.z != 0.0f || lo.body.roll != 0.0f ||
             lo.body.pitch != 0.0f || lo.body.yaw != 0.0f;

  // Lageausgleich: nur im Stehen/Laufen, mit gültigem Lagesensor. Sonst baut sich
  // die Korrektur langsam ab. Soll-Lage inkl. Geste, damit er nicht dagegen regelt.
  if (!leveling_on) g_level.clearFault();
  const bool level_active = leveling_on && imu.ok() && standing && !po.active;
  g_level.setGain(g_gait.idle() ? LEVEL_GAIN_STAND : LEVEL_GAIN_WALK);
  g_level.update(dt, level_active, imu.rollDeg(), imu.pitchDeg(),
                 goal.pose.roll_deg + go.roll + al.body.roll + lo.body.roll,
                 goal.pose.pitch_deg + go.pitch + al.body.pitch + lo.body.pitch);
  goal.pose.roll_deg = clampf(goal.pose.roll_deg + g_level.rollDeg(), -LEVEL_TILT_MAX, LEVEL_TILT_MAX);
  goal.pose.pitch_deg = clampf(goal.pose.pitch_deg + g_level.pitchDeg(), -LEVEL_TILT_MAX, LEVEL_TILT_MAX);

  // Haltung mit begrenzter Geschwindigkeit und Beschleunigung nachführen (fließende,
  // weich beginnende und endende Bewegung). Höhe und Fußabstand aus dem
  // Haltungswechsel direkt (dort schon geglättet bzw. als Sprung gewollt: die Gangart
  // setzt die Füße dann mit Schritten um).
  float* vel = g_pose_vel;
  const float vl = POSE_SPEED_MM_PER_S, al_ = POSE_ACCEL_MM_PER_S2;
  const float va = POSE_SPEED_DEG_PER_S, aa = POSE_ACCEL_DEG_PER_S2;
  kin::BodyPose& c = g_current.pose;
  c.x = glide(c.x, goal.pose.x, vel[0], vl, al_, dt);
  c.y = glide(c.y, goal.pose.y, vel[1], vl, al_, dt);
  c.roll_deg = glide(c.roll_deg, goal.pose.roll_deg, vel[3], va, aa, dt);
  c.pitch_deg = glide(c.pitch_deg, goal.pose.pitch_deg, vel[4], va, aa, dt);
  c.yaw_deg = glide(c.yaw_deg, goal.pose.yaw_deg, vel[5], va, aa, dt);
  if (po.active) {
    c.z = goal.pose.z;
    g_current.stance = goal.stance;
    vel[2] = vel[6] = 0.0f;
  } else {
    c.z = glide(c.z, goal.pose.z, vel[2], vl, al_, dt);
    g_current.stance = glide(g_current.stance, goal.stance, vel[6], vl, al_, dt);
  }
  kin::BodyPose pose = c;
  pose.x += go.x;
  pose.y += go.y;
  pose.z += go.z;
  pose.roll_deg += go.roll;
  pose.pitch_deg += go.pitch;
  pose.yaw_deg += go.yaw;

  // Gang: Füße im Lauf-System (Mittelbeine ggf. vorgesetzt)
  neutralFeet(g_current.stance, neutral);
  neutral[1].x += ao.mid_dx;
  neutral[4].x += ao.mid_dx;
  updateReach(g_current, gp);
  g_gait.setParams(gp);
  // "Lebendig" blendet noch aus (hebt evtl. gerade einen Fuß): so lange keine Schritte
  // beginnen – weder Laufen noch Umsetzen der Füße (Vorderbeine heben, Hinsetzen) –, sonst
  // wären kurz vier Beine in der Luft. Kleine Änderungen (Fußabstand) folgen weiter direkt.
  static kin::Vec3 held[NUM_LEGS];
  static bool have_held = false;
  if (!g_anim.silent() || g_flail.active()) {
    cmd[0] = cmd[1] = cmd[2] = 0.0f;
    bool jump = false;
    for (int leg = 0; leg < NUM_LEGS; ++leg) {
      if (hypotf(neutral[leg].x - held[leg].x, neutral[leg].y - held[leg].y) > 8.0f) jump = true;
    }
    if (have_held && jump) {
      for (int leg = 0; leg < NUM_LEGS; ++leg) neutral[leg] = held[leg];
    }
  }
  for (int leg = 0; leg < NUM_LEGS; ++leg) held[leg] = neutral[leg];
  have_held = true;
  g_gait.setCommand(cmd[0], cmd[1], cmd[2]);
  g_gait.update(dt, neutral);

  // Füße: aus der Gangart, Vorderbeine im Arm-Modus aus dem Vorderbein-Ablauf
  kin::Vec3 feet[NUM_LEGS];
  for (int leg = 0; leg < NUM_LEGS; ++leg) feet[leg] = g_gait.foot(leg);
  if (ao.blend > 0.0f) {
    for (int k = 0; k < 2; ++k) {
      kin::Vec3& f = feet[FRONT_LEGS[k]];
      const kin::Vec3& a = ao.foot[k];
      f = {f.x + (a.x - f.x) * ao.blend, f.y + (a.y - f.y) * ao.blend, f.z + (a.z - f.z) * ao.blend};
    }
  }

  // "Lebendig" zuletzt dazu – so weit, wie die Beine es in dieser Haltung erlauben
  if (!g_anim.silent()) applyAlive(pose, feet, al);
  if (life_on) applyAlive(pose, feet, lo);

  // Augen: atmen mit, gelangweilt gedimmt, Blick in die Bewegungsrichtung, schläft/zappelt
  StatusLeds::Life le;
  if (lc.breathe) le.breath = g_breath.eyeDim();
  if (g_moods.mood() == life::Mood::Bored) le.dim = 0.65f;
  if (lc.gaze) {
    const float wzn = g_gait.maxTurn() > 1e-3f ? g_gait.turnRate() / g_gait.maxTurn() : 0.0f;
    const float vyn = g_gait.maxSide() > 1.0f ? g_gait.speedY() / g_gait.maxSide() : 0.0f;
    const float g = life::gaze(wzn, vyn, al.body.yaw + lo.body.yaw + go.yaw);
    g_gaze += (g - g_gaze) * fminf(1.0f, dt / 0.15f);
    le.gaze = g_gaze;
  }
  if (g_flail.active()) {
    le.style_on = true;
    le.style = {{255, 120, 0}, ledfx::Effect::Strobe};
  } else if (g_moods.mood() == life::Mood::Asleep) {
    le.style_on = true;
    le.style = {{40, 70, 255}, ledfx::Effect::Sleepy};
  } else if (g_anim.action() == alive::Action::Yawn) {
    le.style_on = true;
    le.style = {{90, 110, 255}, ledfx::Effect::Sleepy};
  }
  statusLeds.setLife(le);
  g_life_eyes = true;

  // Gelenkwinkel aller Beine per IK; unerreichbare Beine behalten ihre Werte
  uint8_t unreachable = solveIk(pose, feet, g_angles);
  g_ik_pose = pose;
  uint32_t clamped = servos.setAnglesDeg(g_angles);

  GaitStatus st;
  st.walking = !g_gait.idle();
  st.swing = g_gait.swingMask();
  st.vx = g_gait.speedX();
  st.vy = g_gait.speedY();
  st.wz_deg = g_gait.turnRate() * RAD2DEG;
  st.max_speed = g_gait.maxSpeed();
  st.max_side = g_gait.maxSide();
  st.max_turn_deg = g_gait.maxTurn() * RAD2DEG;
  st.nominal = g_gait.nominalSpeed();
  st.cadence = g_gait.cadence();
  st.type = g_gait.activeType();
  st.switching = g_gait.transitioning();
  st.climb_height = gp.climb_height;

  portENTER_CRITICAL(&g_mux);
  g_unreachable = unreachable;
  g_clamped = clamped;
  g_status = st;
  g_live_pose = pose;
  g_posture = g_seq.state();
  g_arms_state = g_arms.state();
  g_gesture = g_gest.active();
  g_offset_limited = offset_limited || g_arms.limited();
  g_body_active = body_fresh;
  g_alive_act = g_anim.action();
  g_mood = g_moods.mood();
  g_flailing = g_flail.active();
  g_level_active = level_active;
  g_level_corr[0] = g_level.rollDeg();
  g_level_corr[1] = g_level.pitchDeg();
  if (g_level.fault() && g_leveling) {
    // falsche Sensorrichtung: ausschalten und melden (bleibt gemeldet bis zum Einschalten)
    g_leveling = false;
    g_level_fault = true;
    markDirty();
  }
  portEXIT_CRITICAL(&g_mux);
}

}  // namespace

Activity activity() {
  portENTER_CRITICAL(&g_mux);
  Activity a;
  a.pose = g_mode == Mode::Pose;
  a.standing = a.pose && g_posture == posture::State::Standing;
  a.sitting = a.pose && g_posture == posture::State::Sitting;
  a.walking = a.pose && g_status.walking;
  a.arms = a.pose && g_arms_state != arms::State::Down;
  a.arms_up = a.pose && g_arms_state == arms::State::Up;
  a.gesture = a.pose && g_gesture != gestures::Type::None;
  a.alive = g_alive;
  a.leveling = g_leveling;
  a.level_fault = g_level_fault;
  portEXIT_CRITICAL(&g_mux);
  return a;
}

void liveToJson(JsonObject obj) {
  portENTER_CRITICAL(&g_mux);
  const bool ik = g_mode == Mode::Pose;
  const kin::BodyPose p = g_live_pose;
  const GaitStatus st = g_status;
  portEXIT_CRITICAL(&g_mux);
  auto r1 = [](float v) { return roundf(v * 10.0f) / 10.0f; };
  obj["ik"] = ik;
  if (!ik) return;
  JsonArray b = obj["b"].to<JsonArray>();
  b.add(r1(p.x));
  b.add(r1(p.y));
  b.add(r1(p.z));
  b.add(r1(p.roll_deg));
  b.add(r1(p.pitch_deg));
  b.add(r1(p.yaw_deg));
  obj["s"] = st.swing;
  JsonArray v = obj["v"].to<JsonArray>();
  v.add(roundf(st.vx));
  v.add(roundf(st.vy));
  v.add(roundf(st.wz_deg));
}

void toJson(JsonObject obj) {
  portENTER_CRITICAL(&g_mux);
  Mode m = g_mode;
  PoseState t = g_target;
  uint8_t unreachable = g_unreachable;
  uint32_t clamped = g_clamped;
  gait::Params gp = g_gait_params;
  GaitStatus st = g_status;
  posture::State ps = g_posture;
  bool lvl_on = g_leveling, lvl_fault = g_level_fault, lvl_active = g_level_active;
  float lvl_r = g_level_corr[0], lvl_p = g_level_corr[1];
  arms::State arms_state = g_arms_state;
  gestures::Type gest = g_gesture;
  bool offset_limited = g_offset_limited, body_active = g_body_active;
  bool alive_on = g_alive;
  const life::Config lcfg = g_life;
  const life::Mood mood = g_mood;
  const bool flailing = g_flailing;
  alive::Action alive_act = g_alive_act;
  portEXIT_CRITICAL(&g_mux);

  obj["mode"] = m == Mode::Pose ? "pose" : "manual";
  if (m == Mode::Pose) obj["posture"] = posture::stateName(ps);
  JsonObject p = obj["pose"].to<JsonObject>();
  p["x"] = t.pose.x;
  p["y"] = t.pose.y;
  p["z"] = t.pose.z;
  p["roll"] = t.pose.roll_deg;
  p["pitch"] = t.pose.pitch_deg;
  p["yaw"] = t.pose.yaw_deg;
  p["stance"] = t.stance;
  // erreichbarer Bereich je Größe (die anderen wie eingestellt), auf 0,1 gerundet nach innen
  float rng[7][2];
  LimitWhy why[7][2];
  poseRanges(t, rng, why);
  JsonObject r = obj["range"].to<JsonObject>();
  for (int i = 0; i < 7; ++i) {
    JsonArray a = r[POSE_FIELDS[i].key].to<JsonArray>();
    a.add(ceilf(rng[i][0] * 10.0f) / 10.0f);
    a.add(floorf(rng[i][1] * 10.0f) / 10.0f);
  }
  // was den Bereich begrenzt: [Bein 1..6, Gelenk 0..2 (3 = nicht erreichbar), Grenze °] je Rand
  JsonObject rw;
  for (int i = 0; i < 7; ++i) {
    if (why[i][0].leg < 0 && why[i][1].leg < 0) continue;
    if (rw.isNull()) rw = obj["range_why"].to<JsonObject>();
    JsonArray a = rw[POSE_FIELDS[i].key].to<JsonArray>();
    for (int e = 0; e < 2; ++e) {
      if (why[i][e].leg < 0) {
        a.add(nullptr);
        continue;
      }
      JsonArray w = a.add<JsonArray>();
      w.add(why[i][e].leg + 1);
      w.add(why[i][e].joint);
      w.add(roundf(why[i][e].limit));
    }
  }

  JsonObject lv = obj["level"].to<JsonObject>();
  lv["on"] = lvl_on;
  lv["active"] = lvl_active;
  lv["roll"] = roundf(lvl_r * 10.0f) / 10.0f;
  lv["pitch"] = roundf(lvl_p * 10.0f) / 10.0f;
  if (lvl_fault) lv["fault"] = true;

  JsonObject lf = obj["life"].to<JsonObject>();
  lf["breathe"] = lcfg.breathe;
  lf["bored"] = lcfg.bored;
  lf["lift"] = lcfg.lift;
  lf["walk_fx"] = lcfg.walk_fx;
  lf["gaze"] = lcfg.gaze;
  lf["sleep_min"] = lroundf(lcfg.sleep_s / 60.0f);
  lf["lift_sens"] = lcfg.lift_sens;
  lf["mood"] = life::moodName(mood);
  if (flailing) lf["flail"] = true;
  JsonObject al = obj["alive"].to<JsonObject>();
  al["on"] = alive_on;
  if (alive_act != alive::Action::None) al["act"] = alive::actionName(alive_act);

  JsonObject g = obj["gait"].to<JsonObject>();
  g["type"] = gait::typeName(gp.type);  // gewählt (im Lauf: fließender Übergang)
  g["swing_s"] = gp.swing_s;
  g["step_height"] = gp.step_height;
  if (m != Mode::Pose) return;
  g["active"] = gait::typeName(st.type);
  if (gp.type == gait::Type::Climb || st.type == gait::Type::Climb) g["climb_height"] = roundf(st.climb_height);
  if (st.switching) g["switching"] = true;
  g["walking"] = st.walking;
  g["swing"] = st.swing;
  g["vx"] = roundf(st.vx);
  g["vy"] = roundf(st.vy);
  g["wz"] = roundf(st.wz_deg);
  g["max_speed"] = roundf(st.max_speed);
  g["max_side"] = roundf(st.max_side);
  g["max_turn"] = roundf(st.max_turn_deg);
  g["nominal"] = roundf(st.nominal);  // Tempo ohne Reichweitengrenze
  g["cadence"] = roundf(st.cadence * 100.0f) / 100.0f;

  obj["arms"] = arms::stateName(arms_state);
  if (gest != gestures::Type::None) obj["gesture"] = gestures::typeName(gest);
  if (body_active) obj["body"] = true;
  if (offset_limited) obj["offset_limited"] = true;

  JsonArray u = obj["unreachable"].to<JsonArray>();
  JsonArray c = obj["clamped"].to<JsonArray>();
  for (int leg = 0; leg < NUM_LEGS; ++leg) {
    if (unreachable & (1 << leg)) u.add(leg);
    if (clamped & (0x7u << (leg * 3))) c.add(leg);
  }
}

void geometryToJson(JsonObject obj) {
  obj["placeholder"] = GEOMETRY_IS_PLACEHOLDER;
  JsonObject g = obj["leg"].to<JsonObject>();
  g["coxa"] = LEG_GEOMETRY.coxa;
  g["femur"] = LEG_GEOMETRY.femur;
  g["tibia"] = LEG_GEOMETRY.tibia;
  JsonArray mounts = obj["mounts"].to<JsonArray>();
  for (const auto& m : LEG_MOUNTS) {
    JsonObject o = mounts.add<JsonObject>();
    o["x"] = m.x;
    o["y"] = m.y;
    o["angle"] = m.angle_deg;
  }
  const PoseLimits& L = POSE_LIMITS;
  JsonObject lim = obj["limits"].to<JsonObject>();
  lim["height_min"] = L.height_min;
  lim["height_max"] = L.height_max;
  lim["height_default"] = L.height_default;
  lim["stance_min"] = L.stance_min;
  lim["stance_max"] = L.stance_max;
  lim["stance_default"] = L.stance_default;
  lim["shift_max"] = L.shift_max;
  lim["tilt_max"] = L.tilt_max;
  lim["yaw_max"] = L.yaw_max;
  const GaitLimits& G = GAIT_LIMITS;
  JsonObject gl = obj["gait_limits"].to<JsonObject>();
  gl["swing_min"] = G.swing_min;
  gl["swing_max"] = G.swing_max;
  gl["swing_default"] = G.swing_default;
  gl["height_min"] = G.height_min;
  gl["height_max"] = G.height_max;
  gl["height_default"] = G.height_default;
  gl["stride_max"] = G.stride_max;
  obj["knee_min"] = KNEE_MIN_DEG;
}

}  // namespace motion
