Screase3D/Hexapod-MK3/firmware/test_host/kinematics_test.cpp

// Tests der Kinematik auf dem PC (ohne ESP32):
//   g++ -std=c++17 -I../src -I../include kinematics_test.cpp ../src/kinematics/kinematics.cpp -o kin_test && ./kin_test
// Läuft auch in der CI (.github/workflows/firmware.yml).

#include <cmath>
#include <cstdio>
#include <cstdlib>

#include "kinematics/kinematics.h"
#include "robot_geometry.h"

using namespace kin;

static int g_failed = 0;
static int g_checks = 0;

#define CHECK(cond)                                                     \
  do {                                                                  \
    ++g_checks;                                                         \
    if (!(cond)) {                                                      \
      ++g_failed;                                                       \
      std::printf("FEHLER %s:%d: %s\n", __FILE__, __LINE__, #cond);     \
    }                                                                   \
  } while (0)

#define CHECK_NEAR(a, b, tol)                                                          \
  do {                                                                                 \
    ++g_checks;                                                                        \
    double _a = (a), _b = (b);                                                         \
    if (std::fabs(_a - _b) > (tol)) {                                                  \
      ++g_failed;                                                                      \
      std::printf("FEHLER %s:%d: %s = %.4f, erwartet %.4f\n", __FILE__, __LINE__, #a, _a, _b); \
    }                                                                                  \
  } while (0)

static const LegGeometry G = {30.0f, 60.0f, 90.0f};
static const LegMount MOUNTS[] = {
    {60, 40, 45},   {0, 50, 90},   {-60, 40, 135},     // links
    {60, -40, -45}, {0, -50, -90}, {-60, -40, -135},   // rechts
};

static float rnd(float lo, float hi) { return lo + (hi - lo) * (std::rand() / (float)RAND_MAX); }

static void testNeutralPose() {
  for (const auto& m : MOUNTS) {
    JointAngles a{};
    CHECK(legIk(G, m, {G.coxa + G.femur, 0, -G.tibia}, a));
    CHECK_NEAR(a.coxa, 0, 1e-3);
    CHECK_NEAR(a.femur, 0, 1e-3);
    CHECK_NEAR(a.tibia, 0, 1e-3);
  }
}

static void testFkOfZero() {
  Vec3 p = legFk(G, MOUNTS[0], {0, 0, 0});
  CHECK_NEAR(p.x, G.coxa + G.femur, 1e-3);
  CHECK_NEAR(p.y, 0, 1e-3);
  CHECK_NEAR(p.z, -G.tibia, 1e-3);
}

static void testRoundTripAngles() {
  std::srand(42);
  for (const auto& m : MOUNTS) {
    for (int i = 0; i < 2000; ++i) {
      JointAngles a{rnd(-60, 60), rnd(-70, 70), rnd(-80, 80)};
      Vec3 p = legFk(G, m, a);
      // Nur Stellungen, bei denen der Fuß außerhalb der Coxa-Achse liegt.
      // Liegt er dahinter (unter dem Körper), ist die Coxa um 180° mehrdeutig.
      float f = a.femur * 3.14159265f / 180.0f, k = (a.tibia + 90.0f) * 3.14159265f / 180.0f;
      float r_signed = G.coxa + G.femur * std::cos(f) + G.tibia * std::cos(f + k - 3.14159265f);
      if (r_signed < 5.0f) continue;
      JointAngles b{};
      bool ok = legIk(G, m, p, b);
      CHECK(ok);
      if (!ok) continue;
      CHECK_NEAR(b.coxa, a.coxa, 0.05);
      CHECK_NEAR(b.femur, a.femur, 0.05);
      CHECK_NEAR(b.tibia, a.tibia, 0.05);
    }
  }
}

static void testSignConventions() {
  // Femur + hebt den Fuß, Tibia + bewegt ihn nach außen
  Vec3 p0 = legFk(G, MOUNTS[1], {0, 0, 0});
  CHECK(legFk(G, MOUNTS[1], {0, 10, 0}).z > p0.z);
  CHECK(legFk(G, MOUNTS[1], {0, 0, 10}).x > p0.x);

  // Coxa + bewegt den Fuß auf BEIDEN Seiten nach vorne (+x im Körper)
  for (const auto& m : MOUNTS) {
    Vec3 base = legToBody(m, legFk(G, m, {0, 0, 0}));
    Vec3 fwd = legToBody(m, legFk(G, m, {10, 0, 0}));
    CHECK(fwd.x > base.x);
  }

  // Ein Fußpunkt weiter vorne ergibt eine positive Coxa
  for (const auto& m : MOUNTS) {
    Vec3 foot_body = legToBody(m, {G.coxa + G.femur, 0, -G.tibia});
    foot_body.x += 15.0f;
    JointAngles a{};
    CHECK(legIk(G, m, bodyToLeg(m, foot_body), a));
    CHECK(a.coxa > 0);
  }
}

static void testUnreachable() {
  JointAngles a{1, 2, 3};
  CHECK(!legIk(G, MOUNTS[0], {500, 0, 0}, a));
  CHECK(!legIk(G, MOUNTS[0], {0, 0, -50}, a));  // genau unter der Coxa-Achse
  CHECK_NEAR(a.coxa, 1, 0);  // bei Fehler unverändert
}

static void testBodyLegTransform() {
  for (const auto& m : MOUNTS) {
    Vec3 p{12, -34, 56};
    Vec3 q = legToBody(m, bodyToLeg(m, p));
    CHECK_NEAR(q.x, p.x, 1e-3);
    CHECK_NEAR(q.y, p.y, 1e-3);
    CHECK_NEAR(q.z, p.z, 1e-3);
  }
  // Standard-Fußpunkt liegt im Bein-System auf der x-Achse
  Vec3 f = bodyToLeg(MOUNTS[0], stanceFoot(MOUNTS[0], 80));
  CHECK_NEAR(f.x, 80, 1e-3);
  CHECK_NEAR(f.y, 0, 1e-3);
}

static void testWorldToBody() {
  const float h = 70;
  BodyPose level{0, 0, h, 0, 0, 0};
  Vec3 p = worldToBody(level, {100, 20, 0});
  CHECK_NEAR(p.x, 100, 1e-3);
  CHECK_NEAR(p.y, 20, 1e-3);
  CHECK_NEAR(p.z, -h, 1e-3);

  // Gieren +90° (nach links): ein Punkt vorne liegt danach rechts vom Körper
  BodyPose yaw{0, 0, h, 0, 0, 90};
  p = worldToBody(yaw, {100, 0, 0});
  CHECK_NEAR(p.x, 0, 1e-3);
  CHECK_NEAR(p.y, -100, 1e-3);

  // Rollen + (rechte Seite runter): rechter Fuß rückt näher an den Körper
  BodyPose roll{0, 0, h, 10, 0, 0};
  CHECK(worldToBody(roll, {0, -100, 0}).z > -h);
  CHECK(worldToBody(roll, {0, 100, 0}).z < -h);

  // Nicken + (Nase hoch): vorderer Fuß liegt tiefer unter dem Körper
  BodyPose pitch{0, 0, h, 0, 10, 0};
  CHECK(worldToBody(pitch, {100, 0, 0}).z < -h);
  CHECK(worldToBody(pitch, {-100, 0, 0}).z > -h);

  // Verschieben nach vorne: Füße wandern relativ nach hinten
  BodyPose shift{15, 0, h, 0, 0, 0};
  CHECK_NEAR(worldToBody(shift, {100, 0, 0}).x, 85, 1e-3);
}

// Mit den Maßen aus robot_geometry.h muss die Standardhaltung für alle Beine
// erreichbar sein und innerhalb plausibler Gelenkwinkel liegen.
static void testDefaultPose() {
  BodyPose pose{0, 0, POSE_LIMITS.height_default, 0, 0, 0};
  for (int leg = 0; leg < 6; ++leg) {
    const LegMount& m = LEG_MOUNTS[leg];
    Vec3 foot = bodyToLeg(m, worldToBody(pose, stanceFoot(m, POSE_LIMITS.stance_default)));
    JointAngles a{};
    CHECK(legIk(LEG_GEOMETRY, m, foot, a));
    CHECK(std::fabs(a.coxa) < 1.0f);  // Füße stehen in Montagerichtung
    CHECK(std::fabs(a.femur) < 80.0f);
    CHECK(std::fabs(a.tibia) < 80.0f);
    // Standardhaltung = Montagestellung (alle Servos in der Mitte)
    CHECK_NEAR(a.femur, ASSEMBLY_POSE.femur, 0.2);
    CHECK_NEAR(a.tibia, ASSEMBLY_POSE.tibia, 0.2);
  }
  // FK der Montagestellung trifft die Standardhaltung (Fußabstand, Höhe)
  Vec3 c = legFk(LEG_GEOMETRY, LEG_MOUNTS[1], ASSEMBLY_POSE);
  CHECK_NEAR(std::sqrt(c.x * c.x + c.y * c.y), POSE_LIMITS.stance_default, 0.1);
  CHECK_NEAR(-c.z, POSE_LIMITS.height_default, 0.1);
  // Extremwerte der Oberfläche: nur informativ ausgeben
  int unreachable = 0, total = 0;
  const float zs[] = {POSE_LIMITS.height_min, POSE_LIMITS.height_max};
  const float ss[] = {POSE_LIMITS.stance_min, POSE_LIMITS.stance_max};
  for (float z : zs)
    for (float st : ss)
      for (int leg = 0; leg < 6; ++leg) {
        BodyPose p{0, 0, z, 0, 0, 0};
        const LegMount& m = LEG_MOUNTS[leg];
        JointAngles a{};
        ++total;
        if (!legIk(LEG_GEOMETRY, m, bodyToLeg(m, worldToBody(p, stanceFoot(m, st))), a)) ++unreachable;
      }
  std::printf("Info: %d von %d Extremstellungen (Höhe/Fußabstand) nicht erreichbar\n", unreachable, total);
}

// Haltungsprüfung: Standardhaltung ok, zu hoch -> unerreichbar, enge Grenzen -> begrenzt
static void testCheckPose() {
  float lo[18], hi[18];
  for (int i = 0; i < 18; ++i) {
    lo[i] = -135;
    hi[i] = 135;
  }
  Vec3 feet[6];
  for (int i = 0; i < 6; ++i) feet[i] = stanceFoot(LEG_MOUNTS[i], POSE_LIMITS.stance_default);
  BodyPose pose{0, 0, POSE_LIMITS.height_default, 0, 0, 0};
  CHECK(checkPose(LEG_GEOMETRY, LEG_MOUNTS, 6, pose, feet, lo, hi).ok());
  BodyPose high{0, 0, 140, 0, 0, 0};  // länger als Femur + Tibia
  PoseCheck r = checkPose(LEG_GEOMETRY, LEG_MOUNTS, 6, high, feet, lo, hi);
  CHECK(r.unreachable == 0x3F);
  // Femur von Bein 2 nur bis 50° erlaubt (Standardhaltung braucht 55,4°)
  hi[1 * 3 + 1] = 50;
  r = checkPose(LEG_GEOMETRY, LEG_MOUNTS, 6, pose, feet, lo, hi);
  CHECK(r.unreachable == 0);
  CHECK(r.limited == (1u << 1));
}

// Zulässiger Bereich einer Größe: Grenzen gefunden, nur der zusammenhängende Teil um cur
static void testFeasibleInterval() {
  struct Band { float a, b, c, d; };  // zulässig: [a, b] und [c, d]
  auto ok = [](void* ctx, float v) {
    const Band* band = static_cast<const Band*>(ctx);
    return (v >= band->a && v <= band->b) || (v >= band->c && v <= band->d);
  };
  Band band{10.0f, 37.3f, 60.0f, 70.0f};
  float lo, hi;
  feasibleInterval(ok, &band, 20.0f, 0.0f, 100.0f, 16, 6, lo, hi);
  CHECK_NEAR(lo, 10.0, 0.2);
  CHECK(lo >= 10.0f);
  CHECK_NEAR(hi, 37.3, 0.2);
  CHECK(hi <= 37.3f);
  // ganz zulässig -> statische Grenzen
  Band all{-1e9f, 1e9f, 0, 0};
  feasibleInterval(ok, &all, 5.0f, -30.0f, 30.0f, 16, 6, lo, hi);
  CHECK(lo == -30.0f && hi == 30.0f);
  // aktueller Wert unzulässig -> leerer Bereich an cur
  feasibleInterval(ok, &band, 50.0f, 0.0f, 100.0f, 16, 6, lo, hi);
  CHECK(lo == 50.0f && hi == 50.0f);
  // cur an der Grenze
  feasibleInterval(ok, &band, 10.0f, 0.0f, 100.0f, 16, 6, lo, hi);
  CHECK_NEAR(lo, 10.0, 1e-3);
}

// Haltung aus den Winkeln zurückrechnen: Standhaltung und Sitzhaltung
static void testEstimateStance() {
  const float cases[][2] = {{POSE_LIMITS.height_default, POSE_LIMITS.stance_default}, {SIT_HEIGHT, SIT_STANCE},
                            {POSE_LIMITS.height_max - 10.0f, POSE_LIMITS.stance_min + 10.0f}};
  for (const auto& c : cases) {
    BodyPose pose{0, 0, c[0], 0, 0, 0};
    float deg[18];
    bool ok = true;
    for (int i = 0; i < 6; ++i) {
      JointAngles a;
      ok &= legIk(LEG_GEOMETRY, LEG_MOUNTS[i], bodyToLeg(LEG_MOUNTS[i], worldToBody(pose, stanceFoot(LEG_MOUNTS[i], c[1]))), a);
      deg[i * 3] = a.coxa;
      deg[i * 3 + 1] = a.femur;
      deg[i * 3 + 2] = a.tibia;
    }
    CHECK(ok);
    float h, s;
    CHECK(estimateStance(LEG_GEOMETRY, LEG_MOUNTS, 6, deg, h, s));
    CHECK_NEAR(h, c[0], 0.5);
    CHECK_NEAR(s, c[1], 0.5);
  }
}

int main() {
  testFeasibleInterval();
  testEstimateStance();
  testCheckPose();
  testNeutralPose();
  testFkOfZero();
  testRoundTripAngles();
  testSignConventions();
  testUnreachable();
  testBodyLegTransform();
  testWorldToBody();
  testDefaultPose();
  std::printf("%d Prüfungen, %d Fehler\n", g_checks, g_failed);
  return g_failed ? 1 : 0;
}
