Screase3D/Hexapod-MK3/firmware/test_host/pad_test.cpp

// Tests für den Controller (Bluetooth-Bericht, Belegung, Modi):
//   g++ -std=c++17 -Wall -Wextra -Werror -I../src -I../include pad_test.cpp ../src/input/pad.cpp ../src/input/pad_map.cpp -o pad_test && ./pad_test

#include <cmath>
#include <cstdio>
#include <cstring>

#include "input/pad.h"
#include "input/pad_map.h"

using namespace padmap;

static int g_checks = 0, g_failed = 0;
#define CHECK(cond)                                                 \
  do {                                                              \
    ++g_checks;                                                     \
    if (!(cond)) {                                                  \
      ++g_failed;                                                   \
      std::printf("FEHLER %s:%d: %s\n", __FILE__, __LINE__, #cond); \
    }                                                               \
  } while (0)

static bool near(float a, float b, float eps = 1e-3f) { return std::fabs(a - b) < eps; }
constexpr float DT = 0.02f;

static void put16(uint8_t* d, uint16_t v) {
  d[0] = v & 0xFF;
  d[1] = v >> 8;
}

static void testReport() {
  uint8_t d[20] = {};
  put16(d + 0, 65535);  // links: ganz rechts
  put16(d + 2, 0);      //        ganz oben
  put16(d + 4, 32768);  // rechts: Mitte
  put16(d + 6, 65535);  //         ganz unten
  put16(d + 8, 1023);   // LT voll
  put16(d + 10, 0);
  d[12] = 2;     // Steuerkreuz oben rechts
  d[13] = 0x01 | 0x10 | 0x80;  // A, Y, RB
  d[14] = 0x08 | 0x10;         // Menü, Xbox
  d[15] = 0x01;                // Share
  pad::State s;
  CHECK(!pad::parseXboxReport(d, 15, s));
  CHECK(pad::parseXboxReport(d, 16, s));
  CHECK(near(s.lx, 1.0f) && near(s.ly, 1.0f) && near(s.rx, 0.0f) && near(s.ry, -1.0f));
  CHECK(near(s.lt, 1.0f) && near(s.rt, 0.0f));
  using namespace pad;
  const uint32_t want = mask(BTN_A) | mask(BTN_Y) | mask(BTN_RB) | mask(BTN_MENU) | mask(BTN_XBOX) | mask(BTN_SHARE) |
                        mask(BTN_UP) | mask(BTN_RIGHT);
  CHECK(s.buttons == want);
  // Elite 2: Paddles in Byte 18
  d[18] = 0x01 | 0x08;
  CHECK(parseXboxReport(d, 20, s));
  CHECK((s.buttons & mask(BTN_P1)) && (s.buttons & mask(BTN_P4)) && !(s.buttons & mask(BTN_P2)));
  // Steuerkreuz: alle Richtungen
  const uint32_t dirs[9] = {0, mask(BTN_UP), mask(BTN_UP) | mask(BTN_RIGHT), mask(BTN_RIGHT), mask(BTN_RIGHT) | mask(BTN_DOWN),
                            mask(BTN_DOWN), mask(BTN_DOWN) | mask(BTN_LEFT), mask(BTN_LEFT), mask(BTN_LEFT) | mask(BTN_UP)};
  const uint32_t dmask = mask(BTN_UP) | mask(BTN_DOWN) | mask(BTN_LEFT) | mask(BTN_RIGHT);
  for (int h = 0; h <= 8; ++h) {
    d[12] = h;
    parseXboxReport(d, 16, s);
    CHECK((s.buttons & dmask) == dirs[h]);
  }
  for (int i = 0; i < NUM_BUTTONS; ++i) CHECK(buttonFromName(buttonName(i)) == i);
  CHECK(buttonFromName("z") == -1);
}

static Output step(Mapper& m, const pad::State& s) { return m.update(s, DT); }
static pad::State press(int b);
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
