Screase3D/Hexapod-MK3/(commit log)

2026-10-10 Firmware-Grundgerüst: PlatformIO-Projekt, Servo-, Sensor- und Netzwerkmodule
    - PlatformIO (pioarduino, Arduino-Core 3.3 / ESP-IDF 5.5) für ESP32-S3 N16R8
    - Pinbelegung laut Schaltplan v3 und Board-Doku in include/config.h
    - PCA9685-Treiber mit Burst-Schreiben und versetzten Pulsanfängen
    - ServoController: Rampen, gestaffeltes Torque, Not-Aus, Kalibrierung (NVS)
    - Akkuüberwachung 2S mit Tiefentladeschutz, MPU6050 mit Komplementärfilter
    - WLAN (Station mit AP-Fallback, mDNS hexapod.local)
    - HTTP-Server Port 80 (REST + WebSocket), MJPEG-Stream Port 81
    - Status-LEDs (WS2812B-Augen + Board-LED)
    Claude-Session: https://claude.ai/code/se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
2026-10-10 Weboberfläche: Steuerung, Kamerastream, Servo-Kalibrierung, System
    - Single-Page-UI ohne externe Abhängigkeiten (läuft auch im AP-Modus offline),
    gzip-komprimiert in die Firmware eingebettet (~14 KB)
    - Kalibrier-Workflow: Rohmodus-Jog, Neutralstellung/Referenzwinkel übernehmen,
    Drehrichtung, Grenzen, kalibrierter Test, Speichern/Verwerfen/Standard
    - Kamerastream (Port 81) mit Einstellungen, IMU-Lageanzeige, Not-Aus (Esc)
    - System: Status, Komponenten, Akku, WLAN-Zugangsdaten, Export/Import der
    Kalibrierung, Neustart
    - REST-Fallback /api/estop, Tiefschlaf bei tiefentladenem Akku
    - tools/mock_server.py zum Entwickeln der UI ohne Roboter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
2026-10-10 Dokumentation: Schnellstart, Hardware, Kalibrierung, API; kleine Firmware-Fixes
    - README mit Stand/Roadmap, Schnellstart, Architektur
    - docs/hardware.md: Pinbelegung, Servo-Zuordnung, Hinweise zur Schaltung
    - docs/kalibrierung.md: Gelenk-Konvention (Neutralstellung, Drehrichtungen), Ablauf
    - docs/api.md: REST, WebSocket-Befehle, Telemetrie, Stream
    - include/secrets.example.h für optionale WLAN-Standarddaten
    - ServoController: Tick-Puffer auf 16 Kanäle, Initialisierungsreihenfolge
    Claude-Session: https://claude.ai/code/session_01RawtPgihHBCcdXU3CSLmdm
    [secrets.example.h, servo_controller.cpp, servo_controller.h, servo_map.h]
2026-10-10 Akkuüberwachung und Tiefschlaf per Schalter abschaltbar
    - Zwei Schalter im Tab System (Akkuüberwachung, Tiefschlaf bei Tiefentladung),
    gespeichert im NVS; ab Werk ist die Überwachung aus, da GPIO 1 ohne
    bestückten Spannungsteiler offen ist
    - Gemessen wird weiterhin, Anzeige als ungeprüfter Messwert zum Prüfen des Teilers
    - REST GET/POST /api/battery, Telemetrie mit enabled/deep_sleep und Zustand 'off'
    - README: ausführliche Anleitung zum Kompilieren und Flashen
    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
2026-10-10 README: Git als Voraussetzung für die ESP32-Plattform ergänzen
    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
2026-10-10 Kamera-Drehung, manuelle Servosteuerung, I²C-Bus-Scan
    - Kamera: Drehung 0/90/180/270° (180° per Sensor, 90°/270° zusätzlich in der UI),
    persistent im NVS
    - Steuerung: Panel mit Schiebern für alle 18 Gelenke (kalibrierte Winkel,
    Grenzen aus der Kalibrierung)
    - I²C-Scan 0x08–0x77 im Regel-Task, beim Start auf Serial, in der UI unter
    System mit bekannten/fehlenden/unerwarteten Geräten; GET /api/i2c,
    POST /api/i2c/scan
    - MPU6050: stumme Anwesenheitsprüfung vor Registerzugriffen (kein Log-Spam)
    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
2026-10-10 CI: Firmware bei jedem Push bauen und Binärdateien bereitstellen
    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
2026-10-10 Phase 2: inverse Kinematik und Körperhaltung (Pose-Modus)
    - kinematics: IK/FK je Bein, Körper-/Bein-/Welt-Transformationen; reine
    Mathematik, auf dem PC getestet (test_host/, ~38.000 Prüfungen, auch in CI)
    - robot_geometry.h: Beinmaße und Montagepunkte (noch Platzhalter) sowie
    Grenzen der Körperhaltung
    - motion: Pose-Modus im Regel-Task (Höhe, Fußabstand, Verschieben,
    Rollen/Nicken/Gieren) mit Geschwindigkeitsbegrenzung; meldet unerreichbare
    Beine und Gelenke an der Kalibriergrenze
    - UI: Karte 'Körperhaltung (IK)' im Tab Steuerung; GET /api/kinematics;
    WebSocket-Befehle mode/pose/pose_reset
    - docs/kinematik.md: Messanleitung für die Beinmaße
    - README: Firmware ohne Platfo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
2026-10-10 CI ohne Paket-Cache, überholte Läufe abbrechen; Motion: JSON außerhalb des kritischen Abschnitts
    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
2026-10-10 WLAN-Einrichtung über den Access Point ohne lokale Secrets
    - Netzsuche (asynchron, 2,4 GHz, nach Signalstärke sortiert) und Auswahl in der UI
    - Verbinden ohne Neustart: AP+STA, Live-Status, verständliche Fehlergründe
    (Passwort falsch, Netz nicht gefunden …), neue IP wird angezeigt
    - Access Point läuft nach erfolgreicher Verbindung noch 2 Minuten und schaltet
    sich dann ab; Captive Portal (DNS + Weiterleitung) öffnet die Oberfläche beim
    Verbinden automatisch
    - Heimnetz beim Start nicht erreichbar oder verloren: Access Point als
    Rückfallebene, Heimnetz wird im Hintergrund erneut versucht
    - Banner 'WLAN einrichten' im AP-Modus; REST /api/wifi/scan, /api/wifi mit connect
    - READM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
2026-10-11 Diagnose für Kamera-Stream und MPU6050, robusterer Stream
    - Stream: Live-Statistik (fps, KB/Bild, Mbit/s, Kamera-Aussetzer) in der
    Telemetrie und unter dem Bild, zusammen mit der WLAN-Signalstärke
    - Stream toleriert Kamera-Aussetzer bis 3 s, Kopf+Trenner in einem Paket,
    längere Sende-Timeouts; die Oberfläche verbindet sich nach Abbrüchen neu
    - Kamera-Takt (XCLK) 10/16/20 MHz einstellbar (wirkt nach Neustart)
    - MPU6050: Rohwerte der Beschleunigung, Leserate, Temperatur, WHO_AM_I und
    Lesefehler in der Telemetrie/Oberfläche
    - Regel-Task: tatsächliche Zyklusrate und max. Rechenzeit im Tab System
    Claude-Session: https://claude.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
2026-10-11 Beingeometrie aus dem CAD: Maßzeichnung und echte Werte für die IK
    - docs/beingeometrie.svg/.png: Seitenansicht Bein (Coxa 41, Femur 43 @ 15°,
    Tibia 94) und maßstäbliche Draufsicht (Coxa-Achsen 77/114/147 mm, Beine
    45°/90°) mit Körperkontur, Beinnummern, PCA-Kanälen und Kalibrierhinweisen;
    erzeugt von docs/beingeometrie.py
    - robot_geometry.h: Maße eingetragen, kein Platzhalter mehr;
    SERVO_CENTER_POSE (Femur +15°, Tibia -15°) und Standardhaltung
    (Höhe 82,9 mm, Fußabstand 82,5 mm) = alle Servos in der Mitte;
    Grenzen der Oberfläche an die neuen Längen angepasst
    - Test: IK der Standardhaltung trifft die Servo-Mitte
    - Doku/Oberfläche: Montagestellung (1500 µs) vs. 0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
2026-10-11 Kalibrierung mit Bezug auf die Montagestellung (spinnenartige Haltung)
    Die Servohörner werden jetzt bei 1500 µs in der Stehhaltung aufgesteckt
    (Coxa 0°, Femur +30°, Tibia senkrecht = -30°, ASSEMBLY_POSE) statt bei 0°.
    Das liegt mitten im Arbeitsbereich beim Laufen und ist zugleich die
    Standardhaltung der IK (Höhe 72,5 mm, Fußabstand 78,2 mm).
    - Kalibrierung: puls = center_us + (winkel - ref_deg) * us_per_deg,
    center_us = Puls in der Montagestellung; Grenzen um die Montagestellung;
    NVS/JSON Version 2, Version 1 wird beim Laden/Import umgerechnet
    - Befehle: cal_center (statt cal_zero), all_assembly; cal_ref rechnet
    relativ zur Montagestellung; Torque-Start fährt in die Montages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
2026-10-11 Kamera schläft, solange kein Stream läuft
    Der OV5640 wird im Dauerbetrieb sehr heiß, und der Treiber nimmt auch ohne
    Zuschauer ständig Bilder auf. Jetzt:
    - nach 10 s ohne Stream/Abruf (CAM_IDLE_SLEEP_MS): Sensor in den
    Software-Power-Down (OV5640/OV3660 0x3008 Bit 6, OV2640 COM2 Bit 4),
    danach esp_camera_deinit (Takt und DMA aus)
    - /stream und /capture wecken die Kamera (Treiber-Init, Einstellungen,
    erste 2 Bilder verwerfen); Mutex gegen gleichzeitiges Wecken/Schlafen
    - beim Start nur Erkennung, dann sofort schlafen; Sensorname bleibt
    gecacht; Kamera-Takt wirkt jetzt beim nächsten Aufwecken
    - Telemetrie/REST: awake, wake_ms, wakes; Oberfläche zeigt den Zustand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
2026-10-11 Laufen: Gangarten mit Joystick-Steuerung
    - src/kinematics/gait: phasengesteuerte Gangarten Dreifuß, Ripple, Welle
    (reine Mathematik). Standbeine wandern im Lauf-System exakt entgegen der
    Körperbewegung (kein Rutschen), Schwungbeine heben mit ruckfreien
    Profilen ab und setzen weich auf; Aufsetzpunkt so, dass die Standphase
    symmetrisch um die Neutralstellung liegt. Befehl gerampt, Fahren+Drehen
    auf den schnellsten Fuß begrenzt, nach dem Loslassen ein Schritt in die
    Neutralstellung, unnötige Schritte entfallen, Gangart-Wechsel im Stillstand
    - motion: Gang im IK-Modus, Körperhaltung obendrauf; walk/stop/gait,
    Watchdog 600 ms, kein Laufen ohne Torque oder bei Not-Aus; nach dem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
2026-10-11 Aufstehen und Hinsetzen aus der Sitzhaltung
    - src/kinematics/posture: Ablauf sitzen -> aufstehen -> stehen -> hinsetzen
    (reine Logik): Körper bei weit stehenden Füßen ruckfrei heben, dann
    Füße mit Schritten auf den normalen Fußabstand setzen; Hinsetzen
    umgekehrt (gerade ausrichten, Füße nach außen, absenken)
    - Gangart setzt Füße mit Schritten um, wenn die Neutralpunkte im
    Stillstand um mehr als 10 mm springen (kleine Änderungen wie bisher direkt)
    - motion: Sitzhaltung (SIT_HEIGHT 40 mm geschätzt, SIT_STANCE 115 mm) ist
    Startsollwert der Servos, Torque aus/Not-Aus gilt als liegend, Laufen nur
    im Stehen; Befehle stand/sit, Telemetrie motion.posture
    - Oberfläche: Knöp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
2026-10-11 PCA9685 gespiegelt eingebaut: #1 (0x40) rechts, #2 (0x41) links
    Die beiden Servotreiber sitzen seitenverkehrt: PCA #1 (0x40) steuert jetzt
    die rechten Beine 4-6, PCA #2 (0x41) die linken Beine 1-3. Kanäle je Bein
    unverändert (vorne CH0-2, Mitte CH3-5, hinten CH6-8).
    - SERVO_MAP: Beine 1-3 -> Board 1 (0x41), Beine 4-6 -> Board 0 (0x40)
    - Bezeichnungen in config.h, I2C-Scan, Oberfläche und Mock-Server
    - Schaltplan v4 (Beschriftungen der Beine an den PCA getauscht, Hinweis
    ergänzt; v3 entfernt), hardware.md-Tabelle, Maßzeichnung
    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
2026-10-11 Montagestellung = Grundstellung aus dem CAD (Femur 49,3°, Tibia -23,5°)
    Die bisherige Annahme (Femur 30°, Tibia senkrecht unter dem Knie) passte
    nicht zum echten Bein: Das Tibia-Bauteil ist gebogen, die Fußspitze steht
    unter dem Knick, 41 mm außerhalb der Knieachse. Aus der CAD-Seitenansicht
    des aufgebockten Roboters vermessen:
    - ASSEMBLY_POSE = Coxa 0°, Femur +49,3°, Tibia -23,5°
    -> Höhe 52 mm (Femur-Achse über Fußspitze), Fußabstand 110 mm,
    Bodenfreiheit ca. 28 mm; alle Haltungen innerhalb ±60° um diese Mitte
    - Standardhaltung = Montagestellung; Höhe 35-100 mm, Fußabstand 75-135 mm
    - Sitzhaltung: SIT_HEIGHT 23 mm (Chassis 26 mm unter der Femur-Achse,
    Fußspitze ca. 2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
2026-10-11 Grundstellung mit 100 mm Fußabstand, ruhigeres Anlaufen
    - Montagestellung = Grundstellung jetzt Höhe 52 mm / Fußabstand 100 mm:
    Femur +55,4°, Tibia -33,8° (Fuß 34,6 mm außerhalb des Knies). Entlastet
    den Femur um ca. 15 % (Dreifuß ca. 1,7 statt 2 kg·cm). Sitzhaltung
    ebenfalls 100 mm, Aufstehen bleibt ein reines Anheben.
    - Gang: Schrittlänge 35 mm, Fußhub max. 20 mm, damit das Knie am inneren
    Ende des Schritts nicht zu weit einknickt (Standard min. ca. 27°).
    - Anlaufen aus dem Stillstand: Im ersten Zyklus wird so langsam beschleunigt,
    dass das Bein mit dem spätesten Schwungfenster nicht viel weiter nach innen
    wandert als im normalen Lauf (Wellengang vorher fast doppel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
2026-10-12 Weboberfläche neu: Menü links, vier Bereiche, modernes Design
    - Seitenleiste mit Symbolen: am PC einklappbar (wird gemerkt), am Handy
    als Schublade über ☰. Not-Aus bleibt immer oben rechts.
    - Steuerung: großer Kamerastream mit Vollbild und optionalem künstlichem
    Horizont (Lage aus dem MPU6050), Kameraeinstellungen über ⚙; Laufen mit
    Gangart-Umschalter, Körperhaltung, Lage, Servos. Auf dem Handy in der
    Reihenfolge Kamera, Laufen, Lage, Haltung, Servos.
    - Kalibrierung & Justierung: Werkzeugleiste (Torque, 1500 µs,
    Montagestellung, Speichern, Export/Import) und Umschalter Kalibrieren
    (einzeln) / Justieren (alle 18 Gelenke, wie am Roboter angeordnet).
    - Systemübersicht: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
2026-10-12 Linke Seite dreht ohne Kalibrierung andersherum (spiegelbildlicher Aufbau)
    Bisher drehten ohne Kalibrierschritt "Richtung" alle Servos gleich herum
    (+11,1 µs/°). Die Beine sind aber links und rechts spiegelbildlich
    aufgebaut: Femur/Tibia-Servos gespiegelt eingebaut, Coxa-Wellen alle oben,
    "Fuß nach vorne" also links im und rechts gegen den Uhrzeigersinn. Folge:
    Die linken Beine bewegten sich beim Hinsetzen spiegelverkehrt, Laufen ging
    nicht.
    - SERVO_DEFAULT_DIR (servo_map.h): rechts +1, links -1 je Gelenk.
    - Kalibrierdaten Version 3: Servos, deren Richtung nie eingestellt wurde
    (Steigung noch genau der alte Standard), bekommen beim Laden/Import die
    Standardrichtung ihrer Seite. Monta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
2026-10-12 Schneller laufen, Lagesensor kalibrierbar, Lageausgleich, Einstellungen speichern
    Laufen
    - Richtungsabhängige Reichweitengrenze: Die Gangart rechnet aus Körperhöhe,
    Fußabstand und Fußhub, wie weit ein Fuß zur Coxa-Achse darf, ohne dass
    das Knie unter KNEE_MIN_DEG (25°) einknickt (gait::minFootRadius), und
    begrenzt das Tempo nur in dieser Richtung. Außen begrenzt die Beinlänge.
    25 % Reserve fürs Beschleunigen; Beschleunigen dauert mindestens eine
    Standphase, die Grenze gilt schon für das Fahrziel.
    - Schrittlänge 50 statt 35 mm, Schrittdauer 0,4 s (min. 0,3 s), Fußhub bis
    25 mm, Slew-Untergrenze im IK-Betrieb 600 °/s: Dreifuß vorwärts 125 mm/s
    (vorher 70), seitwä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
2026-10-12 Bewegung: Haltung begrenzen mit Hinweis, adaptive Schrittfrequenz, Körper-Modus, Gesten, Vorderbeine
    - Haltung: unerreichbare Werte (Boden nicht erreichbar, Gelenkgrenze) werden auf die
    nächste zulässige Haltung begrenzt; die Antwort nennt, was begrenzt wurde.
    Die Oberfläche zeigt den Hinweis und warnt, wenn die Beinreichweite das Lauftempo
    einschränkt oder Laufen in der Haltung unmöglich ist.
    - Gang: Langsam laufen verlängert die Schrittdauer (bis 2x) statt nur die Schritte zu
    verkürzen - halb so viele Schritte bei 20 % Tempo.
    - Karte "Bewegung" mit drei Joystick-Modi: Laufen, Körper (verschieben/neigen,
    federt zurück, Gesten Kreisen/Ja/Nein/Liegestütz/Tanzen) und Vorde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
2026-10-13 Vorderbeine mit großem Arbeitsraum, Lebendig-Modus, Board-LED aus
    - Vorderbeine: Steuerung um die Coxa (schwenken je 32°, Höhe 15-160 mm,
    gespiegelt zusätzlich ausstrecken/heranziehen). Jeder Zielpunkt wird per IK
    und Gelenkgrenzen geprüft; der Fuß geht so weit, wie das Bein reicht, fährt
    weich an und bremst, wird am Rand langsamer statt zu springen. Absetzen über
    die Bereitstellung senkrecht nach unten.
    - Lebendig (Schalter, gespeichert): im Stand ab und zu umschauen, Gewicht
    verlagern, Kopf schief legen, ein Bein heben, tippen, Füße neu setzen, atmen.
    Immer nur ein Bein in der Luft, Gewicht vorher weg davon; so groß, wie die
    Haltung erlaubt; Laufen und andere Modi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
2026-10-13 Version 0.6.0: Versionsanzeige, LED-Einstellungen, Xbox-Controller
    - Version: Datei firmware/VERSION + Git-Stand + Build-Datum werden beim Build
    eingebettet (scripts/version.py); Anzeige in Einstellungen und Seitenleiste,
    Hinweis bei Seite von älterer Firmware. CHANGELOG.md.
    - LEDs (neue Seite): Farbe und Effekt der Augen je Zustand (Servos aus/an, steht,
    läuft, Vorderbeine, Geste, Access Point), eine Farbe für alles oder aus,
    Helligkeit, Board-LED (nur Start / wie die Augen / aus). Effekte: Dauerlicht,
    Atmen, Blinken, Herzschlag, Blinzeln, Wechselblinken, Regenbogen. Warnungen
    bleiben fest. Vorschau beim Einstellen, gespeichert im NVS.
    - Controller (neue Seite): Xbox-Controll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
2026-10-13 Version 0.7.0: Fahrer-Ansicht, Profile, OTA-Update, Ereignisprotokoll
    - Fahrer-Ansicht: Kamera im Vollbild mit Joysticks, Modus, Aufstehen/Hinsetzen,
    Vorderbeine/Winken, Gesten, HUD und STOP darüber (Handy quer); nutzt den
    vorhandenen Stream.
    - Profile (Haltung + Gang): Normal, Stabil, Gelände, Sport, Schleichen – alle
    auf Erreichbarkeit und Tempo durchgerechnet – plus eigene im Browser.
    - Firmware-Update über WLAN: Upload in den Einstellungen (POST /api/ota, prüft
    das Abbild, Servos vorher stromlos) und ArduinoOTA (Umgebung hexapod_ota).
    - Ereignisprotokoll (GET /api/log): Neustartgrund inkl. Unterspannung/Absturz,
    WLAN, Not-Aus, Servos, Akku, Lagesensor, Controller, Kalib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
2026-10-13 Bluetooth: WLAN-Modem-Sleep während BLE, damit das WLAN nicht abbricht (0.7.1)
    Mit eingeschaltetem Bluetooth trennte und verband sich das WLAN im
    Sekundentakt und der Controller ließ sich nicht koppeln. Das WLAN lief
    mit WIFI_PS_NONE; für den gemeinsamen Betrieb von WLAN und Bluetooth auf
    einer Antenne verlangt der ESP32 aber Modem-Sleep.
    - wifi::setBluetoothActive(): Modem-Sleep nur solange Bluetooth läuft,
    sonst weiterhin ohne Energiesparen (geringste Latenz)
    - weniger Funkzeit für BLE: Suche 30/90 ms (Koppeln) bzw. 30/300 ms,
    Verbindungsintervall 15..30 ms
    - Kopplung erkennt den Controller auch am Namen "Xbox"
    - Ereignisprotokoll: Grund bei WLAN-Trennung, beim Koppeln ob überha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
2026-10-13 Bluetooth: Controller-Intervall unter 30 ms ablehnen, Koppeln robuster (0.7.2)
    Nach dem Verbinden des Xbox-Controllers war das WLAN nicht mehr
    erreichbar. Der Controller fordert ein sehr kurzes Verbindungsintervall
    an; NimBLE nimmt das standardmäßig an, und Bluetooth belegt die
    gemeinsame Antenne dann so oft, dass für das WLAN kaum Zeit bleibt.
    - Verbindung mit 30..50 ms; Wünsche unter 30 ms werden abgelehnt.
    Trennt der Controller kurz nach einer Ablehnung, bekommt er sein
    Intervall ab dann doch (Rückfall, wird protokolliert)
    - Koppeln: scheitert der eigene Verschlüsselungsversuch, weil der
    Controller sie selbst startet, auf die Verschlüsselung warten statt
    abzubrechen; LE Se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
2026-10-13 WebSocket ohne halbe Frames, Oberfläche verbindet sofort neu, Bluetooth robuster (0.7.3)
    Mit eingeschaltetem Bluetooth erschien in der Oberfläche im Sekundentakt
    "Keine Verbindung". Stockt das WLAN, liefert lwIP nach dem Sende-Timeout
    teilweise Schreibvorgänge; httpd_ws_send_frame_async wertet die als
    Erfolg, der nächste Frame landet mitten im Rest des vorigen und der
    Browser verwirft die Verbindung.
    - WebSocket-Sitzungen senden über eigene Funktion: alles oder Fehler.
    Scheitert Telemetrie, wird die Sitzung sauber geschlossen; Fehler
    landen (höchstens alle 10 s) im Ereignisprotokoll
    - Oberfläche: nach Abbruch sofort neu verbinden, Banner "Keine
    Verbindung" erst nach 2,5 s (vorh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
2026-10-13 Telemetrie: Controllername als Kopie statt Zeiger auf ungültigen Speicher (0.7.4)
    Mit verbundenem Controller brach die WebSocket-Verbindung der Oberfläche
    im Sekundentakt ab (Close-Code 1006 jeweils 0,4 s nach dem Verbinden,
    also bei der ersten Telemetrie). padctl::telemetry() schrieb den Namen
    aus einer lokalen const-Kopie des Status: ArduinoJson 7 behandelt
    const char[N] wie ein String-Literal, speichert nur den Zeiger und nimmt
    N-1 als Länge. Beim Serialisieren lag dort Datenmüll; der Browser
    verwirft eine Textnachricht mit ungültigem UTF-8 samt Verbindung.
    Auf dem PC nachgestellt.
    - Name als const char* übergeben (wird kopiert)
    - sys/utf8.h: Kürzen nur an Zeichengrenzen (Meldunge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
2026-10-13 Schneller laufen (70-mm-Schritte), Lageausgleich viermal so schnell (0.8.0)
    - GAIT_LIMITS.stride_max 50 -> 70 mm; gaitStrideMax() kürzt den Schritt
    bei hohem Fußhub (ab 15 mm je mm 2 mm, 25 mm Hub: 50 mm wie bisher),
    damit kein Gelenk im Schwung über ca. 550 °/s muss. Dreifuß in der
    Standardhaltung 175 statt 125 mm/s, Ripple 88, Welle 35 mm/s.
    Profil Sport mit 15 mm Hub (216 mm/s), Profiltexte und Doku angepasst.
    Sprung-Grenze im Gangtest 8 -> 9 mm je Regelschritt (450 mm/s)
    - Lageausgleich: I-Verstärkung 1/s -> 4/s im Stand, 1,5/s beim Laufen;
    Korrekturänderung auf 30 °/s begrenzt (Haltung folgt mit 45 °/s), sonst
    läuft der Regler voraus und schwingt über. Neuer Tes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
2026-10-13 Controller-Seite: großer Controller mit Belegung, Umbelegen per Klick, Sticks tauschen (0.8.1)
    - Belegung als SVG-Grafik eines Xbox-Controllers: jede Taste mit
    Beschriftung und Linie; Sticks/Trigger mit ihrer Funktion je Modus
    (Laufen/Körper/Vorderbeine umschaltbar, folgt dem Modus am Controller)
    - Taste oder Beschriftung antippen öffnet eine Auswahl nach Themen
    (zeigt, auf welchen Tasten eine Funktion schon liegt); Escape/Abbrechen
    - Live: gedrückte Tasten samt Beschriftung leuchten, Sticks bewegen sich
    mit, Trigger füllen sich; Hover hebt Taste, Linie und Kasten hervor
    - schmale Bildschirme: Grafik ohne Beschriftungen plus Liste zum Antippen
    - ersetzt die Karten "Test" und "Ta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
2026-10-13 WLAN beim Start mit mehreren Anläufen, Kamera-Bluetooth-Modus, Diagnose (0.8.2)
    Nach dem Einschalten dauerte die WLAN-Verbindung manchmal über eine
    Minute: Die erste Anmeldung scheitert nach einem Neustart oft kurz
    (AUTH_EXPIRE / 4-Way-Handshake-Timeout, der Router kennt die alte
    Sitzung noch). wifi::begin() wertete das als falsches Passwort, brach
    sofort ab, startete den Access Point und versuchte es erst nach 60 s.
    - Verbindungsversuch = mehrere Anläufe (eigene Wiederholung nach 1 s,
    automatische des Arduino-Kerns währenddessen aus), "Passwort falsch?"
    erst nach drei Ablehnungen in Folge; Start-Zeitlimit 20 s
    - AP-Modus: neue Versuche nach 10/20/40 s, dann jede Minute; mit Geräte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
2026-10-13 Kamerabild einstellbar, Videoaufnahme, Verlauf in der Systemübersicht (0.9.0)
    - Kamera: Sensor-Bildeinstellungen (Helligkeit, Kontrast, Sättigung,
    Schärfe, Belichtungskorrektur, Verstärkungsgrenze, Weißabgleich,
    AEC2/Nachtmodus, Linsen- und Pixelfehlerkorrektur) in NVS und über
    /api/camera; Vorgaben Automatisch/Bewegung/Innen/Draußen/Nacht in der
    Oberfläche. set_framesize nur bei geänderter Auflösung (sonst hakt das
    Bild bei jedem Regler)
    - Videoaufnahme im Browser: Stream mit CORS in ein Canvas, MediaRecorder
    (WebM/MP4), Zeitanzeige und REC im Bild; Stream stoppen speichert
    - sys/history: Ringpuffer 30 min/10 s (Akku, RSSI, Chip-Temperatur,
    Heap), /api/history, histo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
2026-10-14 Gangart im Lauf wechseln, sicherere Schritte am Rand der Reichweite (0.10.0)
    - Gangsteuerung mit gemeinsamem Takt und Bein-Versätzen (kein Driften durch Rundung)
    - Gangwechsel im Lauf: abbremsen bzw. sofort umtakten, Phase je Bein aus der
    Fußstellung, laufende Schwünge enden in ihrem Tempo, Beine finden in den
    Standphasen ins neue Muster; 75 % Tempo bis dahin, nie zwei Nachbarn in der Luft
    - Vorzeitiges Umsetzen, wenn ein Standfuß den Rand der Reichweite erreichen würde;
    Schwungbahn-Schutz für das Knie nah am Körper; Schwung folgt verschobenem Ziel
    - Telemetrie motion.gait.switching, Texte in Oberfläche, Controller und Mock
    - Tests: Gangwechsel aller Paare, Zufalls-Dauertest
    C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
    [gait.cpp, gait.h, gait_test.cpp, motion.cpp, pad_control.cpp]
2026-10-14 3D-Ansicht live, weichere Körperbewegungen (0.11.0)
    - Firmware: {"cmd":"live"} meldet einen Client für 3 s an; er bekommt dann
    {"type":"live"} mit 20 Hz (Gelenkwinkel, Körperlage der IK, Schwungbeine,
    Tempo, gemessene Lage) – nur Clients, die es angefordert haben
    - Oberfläche: Karte „3D-Ansicht“ (Canvas, Vorwärtskinematik): Körper, Beine,
    Schatten, Standfläche, Schwerpunkt-Lot mit Standreserve, Boden wandert beim
    Laufen; Ansichten 3D/Oben/Seite/Vorne, drehen/zoomen; hell/dunkel, Handy
    - Haltung folgt mit begrenzter Beschleunigung (weich anfahren und abbremsen)
    - Mock: Live-Daten aus einer einfachen Gangsimulation mit IK; Doku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
2026-10-14 3D-Ansicht: gebogene Tibia wie im CAD (0.11.1)
    Die Tibia wird mit der Mittellinie des CAD-Umrisses (docs/beingeometrie.py)
    gezeichnet: vom Knie nach außen, Knick, dann nach unten zur Fußspitze.
    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
2026-10-14 WebSocket-Gegendruck bei schwachem WLAN, Signal messen (0.12.0)
    - Telemetrie und Live-Daten nur senden, wenn der Sendepuffer des Clients Platz
    hat (select), höchstens zwei Aufträge je Art in der Warteschlange; sonst
    auslassen statt den Server-Task (und eingehende Fahrbefehle) zu blockieren
    - Zähler ws_drop in der Telemetrie, Anzeige im Tooltip der Verbindung
    - Einstellungen: Karte „Signal messen“ (Live-RSSI, 10-s-Mittel, Vergleich)
    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
2026-10-14 Fehlerbehebungen aus der Code-Durchsicht, Teil 1 (0.12.1)
    - Gang: Bremse, wenn ein wartendes Bein den Rand der Reichweite erreichen
    würde; Tempo gleitet bei geänderten Grenzen (Richtung, Schrittdauer,
    Fußhub), enger werdende Reichweite gleitet; Tests mit 3000 Richtungswechseln
    - motion: keine Schritte, solange "Lebendig" ausblendet; walk nur im
    IK-Betrieb; Moduswechsel wartet auf den laufenden Regelschritt
    - NaN abgefangen (Servo-Sollwerte, IK, Gamepad-Mapper, clampf)
    - Webserver: Lesen des Bodys mit begrenzten Timeouts; servo_us prüft die ID zuerst
    - Controller: Vergessen bei Bluetooth aus, Funk-Timeout nachfordern, gehaltene
    Tasten beim Verbinden, Wiederholung, Tempo beim Speic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
2026-10-14 0.12.2: Aufstehen ohne Sprünge, Kalibrierung im Stehen, OTA-Sperre, WLAN/WebSocket-Fehler
    - Aufstehen hält Standhöhe und Fußabstand vom Beginn fest; Änderungen währenddessen
    ließen den Körper bis zu 65 mm in einem Regelschritt springen (neuer Test)
    - Kalibrierbefehle und Kalibrier-Import schalten in den manuellen Modus, statt im
    IK-Betrieb alle Gelenke springen zu lassen (Mock entsprechend)
    - ArduinoOTA sperrt die Servos wie der Web-Upload; Akku- und Update-Sperre gemeinsam
    - WLAN: Heimnetz weg, während der AP noch nachläuft -> AP bleibt, neuer Versuch
    - WebSocket: eigene Sendefunktion für jede Verbindung (open_fn), Frist ab letztem
    Fortschritt, Clients ohne Abnahme werden n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
2026-10-14 0.13.0: Haltungs-Regler zeigen den erreichbaren Bereich
    - Firmware rechnet je Haltungsgröße den zusammenhängenden zulässigen Bereich bei
    den übrigen Zielwerten (Kinematik + Gelenkgrenzen der Kalibrierung), nur bei
    geändertem Ziel bzw. alle 2 s; Telemetrie motion.range
    - kin::feasibleInterval (grob nach außen, dann halbieren) mit PC-Test
    - Oberfläche: Band unter jedem Regler, Regler stoppt am Rand, Wert am Rand gelb
    - Mock: range passend zur eigenen Begrenzung; Doku
    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
2026-10-14 0.14.0: Seite „Spielereien“ mit Emotes und Choreografien
    - Emotes auf einen Tipp: Hallo, Verbeugen, Freuen, Umschauen, Ängstlich,
    Strecken und die Gesten; steht vorher selbst auf
    - Choreografien aus Emotes, Gesten, Körper, Höhe, Laufen, Vorderbeinen,
    Winken und Pausen; Editor, Endlosschleife, Vorlagen, Export/Import (JSON),
    gespeichert im Browser
    - Abspielen im Browser mit den Befehlen der Handsteuerung; Leertaste,
    zweiter Tipp, Stopp, Seitenwechsel, Not-Aus und Verbindungsabbruch halten an
    und stellen Körper, Vorderbeine und Höhe wieder her
    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
2026-10-14 0.15.0: Mehr Emotes mit Augen, Spiele, Augen-Karte, Controller in der Kopfzeile
    - Emotes Neugierig, Sauer, Angriff, Überrascht, Traurig, Müde, Verliebt, Party;
    alle Emotes mit passenden Augen; „Überrasch mich“
    - Spiele: Orakel und Würfeln
    - Augen frei wählen (Farbfelder, Farbe, Effekt, Dauer, animierte Vorschau);
    Choreografie-Schritt „Augen“; Tempo 50–200 %
    - LED-Effekte flicker, strobe, scan, sleepy (auch für die Zustände), PC-Tests
    - Firmware: Befehl eyes (Vorgabe, nicht über Warnungen), Telemetrie eyes
    - Kopfzeile: Controller-Symbol mit Akku, solange einer verbunden ist
    - Mock: eyes, MOCK_PAD=ble; Doku
    Claude-S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
2026-10-14 0.16.0: Lebendig wirken – Atmen, Langeweile, Zappeln, Laufen mit Charakter, Blick
    - Neuer Baustein life (PC-Tests, auch in der CI): Stimmung (gelangweilt ->
    einschlafen -> aufwachen und strecken), Atmen, Hochheben erkennen und
    zappeln (immer nur eine Dreiergruppe in der Luft), Laufen mit Trägheit,
    Blick voraus und Hüftschwung, Blickrichtung für die Augen
    - Lebendig: Aktionen Gähnen, Seufzen, Strecken (auch ohne Lebendig abspielbar)
    - Augen: atmen mit, gelangweilt gedimmt, schauen in die Bewegungsrichtung,
    schlafen blau, blitzen beim Zappeln; Lagesensor liefert Beschleunigung/Drehrate
    - Einstellungen: Karte „Lebendig wirken“, alles einzeln schaltbar, Einschlafzeit;
    Befehl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
2026-10-15 0.17.0: Zappeln sofort, ausdrucksstärkere Gesten, Oberfläche neu geordnet
    - Hochheben: drei Hinweise (Beschleunigung, Drehung, Neigung gegenüber der
    gewollten Körperlage), empfindlichere Schwellen, auch während eigener
    Bewegungen; Empfindlichkeit einstellbar (life.lift_sens, NVS Fassung 2)
    - Gähnen, Seufzen, Strecken deutlich größer; Strecken mit Vorderbeinen;
    Standsicherheit im PC-Test
    - Steuerung nur noch zum Fahren (Kamera, 3D, Bewegung, kompakte Haltung),
    Zustand zeigt schläft/zappelt
    - Spielereien -> Verhalten, mit Karte Lebendigkeit (alle Verhaltens-Schalter)
    - Neue Seite Kamera & Lagesensor (Vorschau, Kameraeinstellungen, Lage, Sensor)
    - Einstellungen gegliedert: Bewe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
2026-10-15 0.17.1: Kein Sprung mehr beim Einschalten von IK
    - Beim Wechsel in den IK-Betrieb die tatsächliche Haltung aus den Servowinkeln
    schätzen (kin::estimateStance, PC-Test): sitzt er, beginnt IK im Sitzen;
    steht er schon, auf seiner Höhe. Vorher fuhr der Schalter IK (und Hinsetzen
    aus dem Handbetrieb) ihn mit voller Geschwindigkeit in die Standhaltung.
    - Bis die IK-Haltung erreicht ist, Servos höchstens 90 °/s (setSlewCap)
    - Merker g_enter_sitting entfernt; Mock entsprechend; Doku
    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
2026-10-15 0.18.0: IK-Zustand gespeichert, sicheres Einschalten der Servos
    - IK-Betrieb im NVS (Bit FLAG_POSE), nach dem Neustart wieder wie zuletzt;
    ohne Torque beginnt er in der Sitzhaltung
    - Torque ein: jeder Servo zuerst in die sichere Sitzhaltung (setSafePose aus
    motion::begin), dann mit höchstens 45 °/s zum Sollwert; vorher sprang er mit
    voller Geschwindigkeit auf den letzten Sollwert (z. B. Montagestellung)
    - "Alle …"-Befehle ebenso langsam; Notbremse nach 6 s
    - Hinweis in der Karte Haltung, Doku (hardware, kinematik, api)
    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
2026-10-15 Kamera-Zoom: Sensor-Ausschnitt am OV5640, sonst digital (0.19.0)
    - cam_zoom: mittiges Sensorfenster je Zoomstufe (Werte wie esp32-camera),
    Grenze je Auflösung (VGA 4x, SVGA 3,2x, HD 2x, UXGA 1,6x), Host-Test
    - camera: zoom/zoom_max/zoom_hw in /api/camera, Zoom nur im RAM
    - UI: Zoom-Knopf (auch Fahrer-Ansicht), Mausrad, zwei Finger, Doppelklick,
    Regler auf der Kamera-Seite; digitaler Zoom ohne OV5640
    - Mock, CI, Doku, Changelog
    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
2026-10-15 Neue Gangart Klettern: hohe Kastenschritte über Kanten (0.20.0)
    - gait: Typ climb (Muster wie Ripple), Kastenbahn (erst hoch, oben vor,
    senkrecht runter), oben nach außen gegen zu starkes Einknicken des Knies,
    doppelt lange Schritte (x2,25), höchstens 50 mm Schrittlänge
    - Fußhub automatisch so hoch, wie Knie und Femur es zulassen (climbHeight,
    bis 50 mm); Reichweite mit Kletter-Bahn und Femur-Grenze
    - Wechsel von/zu Klettern im Lauf: kurz anhalten, dann neu anlaufen
    - UI: Knopf Klettern, Profil Klettern, Fußhub-Anzeige; Controller-Text;
    Mock; Tests (Kastenbahn, Gelenke, Wechsel); Doku, Changelog
    Claude-Session: https://cl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
2026-10-16 Kamera: Rand abschneiden (OV5640 im Sensor), Kamera-Symbol in der Kopfzeile (0.21.0)
    - cam_zoom: Streifen an einer Sensorseite nicht auslesen (Seitenverhältnis
    bleibt), Zoom im verbleibenden Bild, Grenzen je Auflösung; Host-Test
    - camera: crop (0..40 %) und crop_edge (unten/oben im angezeigten Bild,
    über Drehung und Spiegeln auf die Sensorseite umgerechnet), gespeichert
    - UI: Regler und Seite auf der Kamera-Seite; ohne OV5640 blendet die
    Oberfläche den Streifen aus; Kamera-Symbol, solange ein Stream läuft;
    Handy: leere Akku-Pille ausgeblendet
    - Mock, Doku, Changelog
    Claude-Session: https://claude.ai/code/session_01RawtPgih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
2026-10-16 Kamera: Rand abschneiden ohne Vergrößern; WLAN-Energiesparmodus anzeigen (0.22.0)
    - cam_zoom: abgeschnittener Streifen verkleinert die Bildgröße (z. B. 640x320),
    Fenster im gleichen Maßstab, Zoom unverändert bis 4x; bis 50 %; Host-Test
    - camera: set_res_raw mit der verkleinerten Bildgröße, out_w/out_h im Status
    - UI: Bildfläche im Format des Streams; ohne OV5640 schneidet die Oberfläche
    ab (object-fit cover) statt zu vergrößern
    - WLAN: Energiesparmodus (Modem-Sleep, nur mit Bluetooth) in Status und
    Telemetrie; Anzeige in Systemübersicht, WLAN-Einstellungen, Stream-Statistik
    Claude-Session: htt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
2026-10-16 Haltungsregler zurück auf die Steuerung, Grenzgrund anzeigen, Klettern schneller (0.23.0)
    - UI: Haltungsregler, Lageausgleich und Zurücksetzen wieder in der Karte
    Haltung auf der Steuerung; Einstellungen behalten Schritt und Servos
    - motion: range_why – je Regler-Rand Bein, Gelenk und Kalibriergrenze, die
    den Bereich begrenzen; UI zeigt das unter den Reglern mit Sprung zum Servo
    - gait: Klettern im Dreifuß-Muster, Schwung 2x (mind. 0,7 s), Schritte bis
    60 mm, Hub bis 45 mm, Kastenbahn 40 % heben/senken -> 75 statt 28 mm/s
    - Mock (MOCK_Z_MAX), Tests, Doku, Changelog
    Claude-Session: https://claude.ai/code/session_01RawtPgihHBC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
2026-10-16 Oberfläche auf Englisch umschaltbar, Stufe 1 (0.24.0)
    - web/i18n.js: Wörterbuch Deutsch -> Englisch (gut 630 Texte: Menü, Titel,
    Kopfzeile, Knöpfe, Beschriftungen, Regler, Gangarten, Profile, Emotes,
    LEDs, Controller, kurze Meldungen) plus Muster für Texte mit Zahlen;
    übersetzt das Dokument beim Laden und alle späteren Änderungen
    (MutationObserver), auch alert/confirm
    - Einstellungen -> Oberfläche: Sprache Deutsch (Standard) / English /
    Automatisch (Browser), Wechsel lädt neu
    - README, Changelog
    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
2026-10-17 Englische Oberfläche, Stufe 2: Hilfetexte und Sätze mit Werten (0.25.0)
    - i18n.js: EN_HTML ersetzt ganze Absätze mit Links/Hervorhebungen (gut
    40 Hilfetexte), weitere Einträge und Muster (Verlauf, Stimmung,
    Schritte, Antwortzeit, Controller-Status ...); Tooltips an
    Eingabefeldern werden jetzt auch übersetzt
    - app.js: lang(de, en) für zusammengesetzte Sätze (WLAN, Akku, Reichweite,
    Kamera, Controller, Signalmessung, Profile, Update, Rückfragen, 3D)
    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
2026-10-17 Englische Oberfläche, Stufe 3: Meldungen der Firmware (0.26.0)
    - i18n.js: EN_FMT mit den printf-Vorlagen der Firmware (Ereignisprotokoll,
    Befehlsfehler, Controller-Meldungen, WLAN-/Neustartgründe), daraus
    automatisch erzeugte Muster; eingesetzte Werte werden mitübersetzt;
    Haltungsbegrenzung, WLAN verbunden, Code-Zusätze, Symbol-Präfixe
    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
2026-10-17 Neue Seite KI: Farbverfolgung – anschauen, drehen, folgen (0.30.0)
    - Ziel per Tippen ins Kamerabild (Farbe 5x5 gemittelt, Schwellen passend
    vorbelegt); Erkennung im Browser: HSV-Maske, größtes zusammenhängendes
    Objekt, geglättet, ca. 10 Bilder/s bei 160 px Breite
    - Betriebsarten: Anschauen (Körper giert/nickt), Drehen (auf der Stelle),
    Folgen (hin bzw. zurück bis zur eingestellten Größe = Abstand); Suchen
    nach Zielverlust; nur im Stehen, aus beim Verlassen der Seite
    - Markierung und optional erkannte Bildpunkte als Overlay (dreht mit),
    Einstellungen im Browser gespeichert; deutsch/englisch
    - README (Seite KI mit Bild), Changelog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
2026-10-17 STL upload
    [BasePlate.stl, BatteryFlap.stl, DeckPlate.stl, ESP_Cam Holder.stl, Left Coxa inner.stl, Left Coxa outer.stl, Left Eye.stl, Left Femur.stl]
2026-10-17 KI: Abstand ruhiger halten, Helligkeit automatisch ausgleichen (0.31.0)
    - Abstand als relative Entfernung mit PD-Regler und Hysterese (±5 %/15 %),
    Median-Filter der Größe, kein Vorlaufen bei abgeschnittenem Ziel
    - Helligkeitsschwelle folgt Bild- und Zielhelligkeit, Farbton wird langsam
    nachgeführt; Schatten/Glanz zählen per Hysterese-Schwelle mit
    - Fläche nahe der letzten Lage bevorzugt; Status zeigt Soll-Abstand
    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
2026-10-17 KI: Augen in der Zielfarbe, schnell blinkend bei verlorenem Ziel (0.32.0)
    - Tracking aktiv: Augen leuchten in der Zielfarbe, Ziel verloren: schnell
    blinken, wiedergefunden: Dauerlicht; abschaltbar, Vorgabe läuft nach 2,5 s
    von selbst aus, Aus/Seite verlassen setzt sofort zurück
    - Neuer Augen-Effekt blink_fast (4 Hz) in Firmware, LED-Seite, Mock, Doku
    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
2026-10-17 KI: Abstand in cm schätzen und anzeigen, Verlaufsgrafik, Einmessen (0.33.0)
    - Abstand aus Durchmesser im Bild, Objektgröße und Brennweite; Anzeige im
    Status, am Ziel und als Verlauf (Abstand/Soll/Haltebereich, Lauf-Befehl)
    - Soll-Abstand in cm; Karte „Abstand messen“ mit Objektgröße und Einmessen
    - Zoom/Ausschnitt des OV5640 herausgerechnet; oben/unten angeschnittenes
    Ziel: Durchmesser aus der Breite
    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
2026-10-31 Docs: Kalibrierung und Hardware auf Englisch
    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
2026-10-31 Docs: API und Controller auf Englisch
    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
2026-10-31 Docs: Kinematik und Gangarten auf Englisch
    Alte deutsche Sprungmarken bleiben als <a id> erhalten, damit Links aus
    api.md und kalibrierung.md weiter funktionieren.
    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
